PaulLSK/Iridium_9603_Beacon/Iridium_9603_Beacon_V5_BOM_Digikey.xls

Part | Quantity | X | Y | Angle | Package | Value | Manufacturer | Manufacturer Part No | Farnell Part No | Digikey P/N | McMaster Part No | Description | Alternative Part
C1,C7,C14,C15 | 4 | 30.48 | 23.91 | 180 | 0603 | 1uF | Walsin | 0603X105K100CT | 2496916 | 1276-1946-1-ND |  | MultiLayer Ceramic Capacitor; 1uF; 10V; 0603; X5R | 1uF 50V ±10% 0603 Samsung
C2,C4 | 2 | 40.96 | 26.45 | 0 | 0603 | 12pF | Walsin | 0603N120J500CT | 2496884 | 709-1141-1-ND |  | MultiLayer Ceramic Capacitor; 12pF; 50V; 0603 | 12pF 50V ±5% 0603 Samsung
C3,C5,C6,C8,C10,C19 | 6 | 16.26 | 35.21 | 270 | 0805 | 10uF | Walsin | 0805F106Z100CT | 2496998 | 1276-2717-1-ND |  | MultiLayer Ceramic Capacitor; 10uF; 10V; 0805 | 10uF 16V ±10% 0805 Samsung
C9,C13 | 2 | 15.24 | 38.13 | 0 | 0805 | 0.1uF | Walsin | 0805B104K500CT | 2496944 | 478-3755-1-ND |  | MultiLayer Ceramic Capacitor; 0.1uF; 50V; 0805; X7R | 100nF 50V ±10% 0805 Samsung
C16 | 1 | 36.77 | 46.70 | 0 | 0603 | 0.22uF | Multicomp | MC0603F224Z160CT | 1759019 | 311-1426-1-ND |  | MultiLayer Ceramic Capacitor; 0.22uF; 16V; 0603 | 220nF 25V ±10% 0603 Samsung
C17 | 1 | 36.80 | 54.45 | 0 | 0805 | 2.2uF | Multicomp | MCTT21X225K100CT | 1759477 | 445-1420-6-ND |  | MultiLayer Ceramic Capacitor; 2.2uF; 10V; 0805; X5R | 2.2uF 25V ±10% 0805 Samsung
C18 | 1 | 2.95 | 59.94 | 180 | 0805 | 10nF | Walsin | 0805B103K500CT | 2496939 | 1276-1015-6-ND |  | MultiLayer Ceramic Capacitor; 10nF; 50V; 0805; X7R | 10nF 50V ±5% 0805 Samsung
CON1 | 1 | 32.83 | 2.99 | 0 |  | Micro_USB | Amphenol_FCI | 10103594 | 2293752 | 609-4050-1-ND |  | Amphenol FCI 10103594 Micro USB Type B | A01SB7X4X1B21-167 Micro USB 5S B
CON4 | 1 | 44.89 | 59.98 | 90 | uFL | uFL | Hirose | U.FL-R-SMT(01) | 3908021 | H9161-ND |  | HIROSE U.FL-R-SMT(01); U.FL Coaxial; Straight Jack; 50 ohm
D1,D2,D3,D4,D5,D6 | 6 | 20.99 | 50.58 | 180 | SOD-123 | MBR120 | ON SEMICONDUCTOR | MBR120VLSFT1G | 1431044 | MBR120VLSFT1GOSDKR-ND |  | Schottky Rectifier; 20V; 1A; SOD-123
J1 | 1 | 26.27 | 42.10 | 0 |  | SS4-10-3.50 | Samtec | SS4-10-3.50-L-D-K-TR | 2085336 | SAM13255CT-ND |  | Samtec SS4-10-3.50-L-D-K-TR
L1 | 1 | 11.78 | 59.98 | 0 | 0805 | 33nH | Coilcraft | 0805HT-33NTGLB | 2286465 | 732-1783-1-ND |  | Surface Mount High Frequency Inductor; 0805; 33 nH; 600 mA | LQW2BHN33NJ03L Murata
LED1 | 1 | 25.05 | 8.83 | 0 |  | WS2812B | Sparkfun / Worldsemi | WS2812B |  | 1568-1800-ND |  | RGB LED with Driver
LED2 | 1 | 29.59 | 9.02 | 180 | 2.0x1.25 | RED | Wurth Electronik | 150080RS75000 | 2322077 | 732-4984-6-ND |  | LED; Red; 20mA; 2V; 2.0x1.25mm | Replaces Multicomp 703-0107
Q1,Q2,Q3,Q4 | 4 | 15.56 | 41.05 | 90 | SOT23 | DMG3415U-7 | Diodes Inc. | DMG3415U-7 | 1843688 | DMP2045U-7DIDKR-ND |  | MOSFET; P Channel; SOT23-WIDE
Q5 | 1 | 33.05 | 19.15 | 180 | SOT23 | 2N2222 | Fairchild | MMBT2222A | 9846700 | MMBT2222ATPMSDKR-ND |  | Bipolar (BJT) Single Transistor, NPN, 40 V, 350 mW, 1 A
R1,R3,R4,R6,R12,R13 | 6 | 19.37 | 40.93 | 270 | 0805 | 100k | Multicomp | MC01W08051100K | 9332405 | RMCF0805FG100KCT-ND |  | Chip Resistor; Thick Film; 100k; 150V; 0805; 100mW | 100K ±1% 0805 RoyalOhm
R2 | 1 | 48.32 | 46.86 | 0 | 0805 | 12K | Panasonic | ERJ6ENF1202V | 2303661 | RMCF0805FT12K0DKR-ND |  | Chip Resistor; Thick Film; 12k; 150V; 0805; 125mW | 12K ±1% 0805 RoyalOhm
R5,R8,R10,R14 | 4 | 16.95 | 29.85 | 0 | 0603 | 1K | Multicomp | MCWR06X1001FTL | 2447272 | 1276-3484-6-ND |  | Chip Resistor; Thick Film; 1k; 50V; 0603; 100mW | 1K ±1% 0603 RoyalOhm
R7 | 1 | 35.37 | 13.72 | 0 | 0603 | 47k | Multicomp | MCWR06X4702FTL | 2447376 | 1276-4808-6-ND |  | Chip Resistor; Thick Film; 47k; 50V; 0603; 100mW | 47K ±1% 0603 RoyalOhm
R9 | 1 | 8.00 | 59.98 | 180 | 0805 | 10 ohm | Multicomp | MC01W0805110R | 9332421 | A106055DKR-ND |  | Chip Resistor; Thick Film; 10 ohm; 150V; 0805; 100mW | 10R ±1% 0805 RoyalOhm
R11 | 1 | 53.40 | 46.86 | 180 | 0805 | 30K | Panasonic | ERJ6GEYJ303V | 2323830 | A126360DKR-ND |  | Chip Resistor; Thick Film; 30k; 150V; 0805; 125 mW | 30K ±1% 0805 RoyalOhm
R15,R16,R17 | 3 | 32.83 | 39.18 | 180 | 0603 | 10K | Multicomp | MCWR06X1002FTL | 2447230 | RNCP0603FTD10K0CT-ND |  | Chip Resistor; Thick Film; 10k; 50V; 0603; 100mW | 10K ±1% 0603 RoyalOhm
SW1 | 1 | 24.13 | 3.18 | 180 | 4.6x2.8 | Tactile Switch | Multicomp | MCIPTG23K-V | 1605470 | CKN10246CT-ND |  | Tactile Switch; 4.6x2.8mm; 50mA; 12V
U1 | 1 | 29.69 | 20.22 | 0 | SOT23-3 | MCP111T-240E/TT | Microchip | MCP111T-240E/TT | 1627192 | MCP111T-240E/TTDKR-ND |  | Reset Supervisor; SOT23-3; 2.40V; Open Drain; Active Low
U2 | 1 | 17.78 | 24.16 | 270 | SOT23-5 | SPX3819-3.3 | Exar | SPX3819M5-L-3-3/TR |  | 1016-1873-6-ND |  | LDO Voltage Regulator; 500mA; SOT-23-5
U3 | 1 | 39.05 | 43.02 | 90 | DFN-10 | LTC3225EDDB | Linear Technology | LTC3225EDDB#TRMPBF | 1715231 | LTC3225EDDB-1#TRMPBFCT-ND |  | Supercapacitor Charger
U4 | 1 | 12.03 | 33.69 | 180 | LGA8 | MPL3115A2 | NXP | MPL3115A2 | 2009084 | MPL3115A2-ND |  | Pressure Sensor
U5 | 1 | 30.48 | 30.26 | 90 | TQFN48 | ATSAMD21G18A | Atmel | ATSAMD21G18A-MF | 2460544 | ATSAMD21G18A-MFTDKR-ND |  | ATSAMD21G18A-MF; QFN48
U6 | 1 | 9.41 | 52.63 | 270 |  | MAX-M8Q | u-blox | MAX-M8Q |  | 672-1003-6-ND |  | https://www.u-blox.com/en/product/max-m8-series
U7 | 1 | 35.46 | 9.75 | 0 | MSOP8 | LT1634BCMS8-1.25 | Linear Technology | LT1634BCMS8-1.25 | 2252797 | LT1634BCMS8-1.25#PBF-ND |  | 1.25V Precision Voltage Reference
X1 | 1 | 37.66 | 27.72 | 270 | 3.2x1.5 | 32.768 | Epson | Q13FC13500004 | 1278036 | SER4103DKR-ND |  | Crystal; 32.768kHz; 12.5pF; 3.2 x 1.5mm
BAT1, BAT2, BAT3 | 6 |  |  |  |  | AA-Clip_Pair | Keystone Electronics | 92 | 908733 | 36-92-ND |  | Keystone Electronics 92 AA Battery Clip (Pair)
C11,C12 | 2 |  |  |  |  | 1F 2.7V | Bussmann | HV0810-2R7105-R | 2148482 | 283-4198-ND |  | Supercapacitor; 1F; 2.7V; +30%, -10%; 3.5mm Pitch
CON2,CON3 | 2 |  |  |  |  | SMA Jack | Johnson | 142-0711-821 | 1019328 | J629-ND |  | SMA End Launch Jack
RELAY1 | 1 |  |  |  |  | DPDT Latching | Omron | G6SK-2 3VDC |  | Z5234-ND |  | DPDT Latching Relay (Dual Coil) 3VDC
CABLE | 1 |  |  |  |  |  | HIROSE (HRS) | U.FL-2LP-088K1T-A-50 | 1688071 | H125218-ND |  | HIROSE u.FL - u.FL cable 50ohm 50mm
