PaulLSK/Iridium_9603_Beacon/Eagle/Iridium Board V5M - BOM for AAPCB - Revision 2.xlsx

Mfg Part # | Description | Value | Pkg | Description Value Pkg *AAPCB Format* | Ref. Des. | Qty | DNI | Notes | Mfg (Optional) | Vendor (Optional) | Vendor Part # (Optional) | Alternate Mfg Part # (Optional) | Type (Optional)
CL10B105KP8NNNC | CAP CER | 1uF 10V 10% | 0603 SMD | CAP CER 1uF 10V 10% 0603 SMD | C1,C7,C14,C15 | 4 |  |  | Samsung | Digi-key | 1276-1946-1-ND
500R14N120JV4T | CAP CER | 12 pF 50V 5% | 0603 SMD | CAP CER 12 pF 50V 5% 0603 SMD | C2,C4 | 2 |  |  | Johanson | Digi-key | 709-1141-1-ND
CL21X106KPCLRNC | CAP CER | 10uF 10V 10% | 0805 SMD | CAP CER 10uF 10V 10% 0805 SMD | C3,C5,C6,C8,C10,C19 | 6 |  |  | Samsung | Digi-key | 1276-2717-1-ND
08053C104KAT2A | CAP CER | 0.1UF 25V 10% | 0805 SMD | CAP CER 0.1UF 25V 10% 0805 SMD | C9,C13 | 2 |  |  | AVX | Digi-key | 478-3755-1-ND
CC0603KRX7R7BB224 | CAP CER | 0.22uF 16V 10% | 0603 SMD | CAP CER 0.22uF 16V 10% 0603 SMD | C16 | 1 |  | Alternate Part: 220nF 25V ±10% 0603 Samsung | Yageo | Digi-key | 311-1426-1-ND
CL21B225KAFNFNE | CAP CER | 2.2uF 25V 10% | 0805 SMD | CAP CER 2.2uF 25V 10% 0805 SMD | C17 | 1 |  |  | Samsung | Digi-key | 1276-2953-1-ND
CL21B103KBANNNC | CAP CER | 10nF 50V 10% | 0805 SMD | CAP CER 10nF 50V 10% 0805 SMD | C18 | 1 |  |  | Samsung | Digi-key | 1276-1015-6-ND
10103594-0001LF | CONN RCPT | USB2.0 | MICRO B SMD | CONN RCPT USB2.0 MICRO B SMD | CON1 | 1 |  |  | Amphenol | Digi-key | 609-4050-1-ND
U.FL-R-SMT(01) | CONN U.FL RCPT | STR 50 OHM | SMD | CONN U.FL RCPT STR 50 OHM SMD | CON4 | 1 |  |  | Hirose | Digi-key | H9161-ND
MBR120VLSFT1G | DIODE SCHOTTKY | 20V 1A | SOD-123 SMD | DIODE SCHOTTKY 20V 1A SOD-123 SMD | D1,D2,D3,D4,D5 | 5 |  |  | ON Semi | Digi-key | MBR120VLSFT1GOSDKR-ND
SS4-10-3.50-L-D-K-TR | .4MM SOCKET STRIP | 20 POS | SMD | .4MM SOCKET STRIP 20 POS SMD | J1 | 1 |  |  | Samtec | Digi-key | SAM13255CT-ND
74476013C | FIXED IND | 33nH 500mA 270 MOHM | 0805 SMD | FIXED IND 33nH 500mA 270 MOHM 0805 SMD | L1 | 1 |  |  | Wurth Elec | Digi-key | 732-1783-1-ND
COM-13667 | LED | RGB | SMD | LED RGB SMD | LED1 | 1 |  | Must be this part number. | Sparkfun | Sparkfun | SMD LED - RGB WS2812B
150080RS75000 | LED | RED CLEAR | 0805 SMD | LED RED CLEAR 0805 SMD | LED2 | 1 |  |  | Wurth Elec | Digi-key | 732-4984-6-ND
DMP2045U-7 | MOSFET P-CHAN | 24V | SOT-23 SMD | MOSFET P-CHAN 24V SOT-23 SMD | Q1,Q2,Q3,Q4 | 4 |  |  | Diodes Inc | Digi-key | DMP2045U-7DIDKR-ND
MMBT2222A-TP | TRANS NPN | 40V 0.6A | SOT-23 SMD | TRANS NPN 40V 0.6A SOT-23 SMD | Q5 | 1 |  |  | Micro Commercial | Digi-key | MMBT2222ATPMSDKR-ND
RMCF0805FG100K | RES | 100K 1% 1/8W | 0805 SMD | RES 100K 1% 1/8W 0805 SMD | R1,R3,R4,R6,R12,R13 | 6 |  |  | Stackpole Elec | Digi-key | RMCF0805FG100KCT-ND
RMCF0805FT12K0 | RES | 12K 1% 1/8W | 0805 SMD | RES 12K 1% 1/8W 0805 SMD | R2 | 1 |  |  | Stackpole Elec | Digi-key | RMCF0805FT12K0DKR-ND
RC1608F102CS | RES | 1K 1% 1/10W | 0603 SMD | RES 1K 1% 1/10W 0603 SMD | R5,R8,R10,R14 | 3 |  |  | Samsung | Digi-key | 1276-3484-6-ND
RC1608F473CS | RES | 47K 1% 1/10W | 0603 SMD | RES 47K 1% 1/10W 0603 SMD | R7 | 1 |  |  | Samsung | Digi-key | 1276-4808-6-ND
CRG0805F10R | RES | 10 1% 1/8W | 0805 SMD | RES 10 1% 1/8W 0805 SMD | R9 | 1 |  |  | TE Connectivity | Digi-key | A106055DKR-ND
CRG0805F30K | RES | 30K 1% 1/8W | 0805 SMD | RES 30K 1% 1/8W 0805 SMD | R11 | 1 |  |  | TE Connectivity | Digi-key | A126360DKR-ND
RNCP0603FTD10K0 | RES | 10K 1% 1/8W | 0603 SMD | RES 10K 1% 1/8W 0603 SMD | R15,R16,R17 | 3 |  |  | Stackpole Elec | Digi-key | RNCP0603FTD10K0CT-ND
KMR231NG LFS | SWITCH TACTILE SPST-NO | 0.05A 32V | SMD | SWITCH TACTILE SPST-NO 0.05A 32V SMD | SW1 | 1 |  |  | C&K | Digi-key | CKN10246CT-ND
MCP111T-240E/TT | IC VOLT DET | 2.32V LOW | SOT-23-3 SMD | IC VOLT DET 2.32V LOW SOT-23-3 SMD | U1 | 1 |  |  | Microchip | Digi-key | MCP111T-240E/TTDKR-ND
SPX3819M5-L-3-3/TR | IC REG LINEAR | 3.3V 500mA | SOT-23-5 SMD | IC REG LINEAR 3.3V 500mA SOT-23-5 SMD | U2 | 1 |  |  | MaxLinear | Digi-key | 1016-1873-6-ND
LTC3225EDDB-1#TRMPBF | IC SUPERCAP CHARGER | 150mA | 10-DFN SMD | IC SUPERCAP CHARGER 150mA 10-DFN SMD | U3 | 1 |  |  | Linear | Digi-key | LTC3225EDDB-1#TRMPBFCT-ND
MPL3115A2 | IC ALTIMETER I2C |  | 8-LGA SMD | IC ALTIMETER I2C 8-LGA SMD | U4 | 1 |  |  | NXP USA | Digi-key | MPL3115A2-ND
ATSAMD21G18A-MFT | IC MCU 32BIT 256KB FLASH |  | 48-QFN | IC MCU 32BIT 256KB FLASH 48-QFN | U5 | 1 |  |  | Microchip | Digi-key | ATSAMD21G18A-MFTDKR-ND
MAX-M8Q-0 | IC RECEIVER GPS/GNSS |  | 18LCC SMD | IC RECEIVER GPS/GNSS 18LCC SMD | U6 | 1 |  |  | U-Blox America | Digi-key | 672-1003-6-ND
LT1634BCMS8-1.25#PBF | IC VREF SHUNT | 1.25V | 8-MSOP SMD | IC VREF SHUNT 1.25V 8-MSOP SMD | U7 | 1 |  |  | Linear | Digi-key | LT1634BCMS8-1.25#PBF-ND
FC-135 32.7680KA-A5 | CRYSTAL | 32.7680 kHz 12.5 pF | SMD | CRYSTAL 32.7680 kHz 12.5 pF SMD | X1 | 1 |  |  | EPSON | Digi-key | SER4103DKR-ND
92 | BATT CONTACT CLIP |  | PC PIN | BATT CONTACT CLIP PC PIN | BAT1,BAT2,BAT3,BAT4,BAT5,BAT6 | 12 | DNI |  | Keystone Elec | Digi-key | 36-92-ND
HV0810-2R7105-R | CAP | 1F -10% +30% 2.7V | RADIAL | CAP 1F -10% +30% 2.7V RADIAL | C11,C12 | 2 | DNI |  | Eaton | Digi-key | 283-4198-ND
G6SK-2 DC3 | RELAY TELECOM DPDT | 2A 250V | PC PIN | RELAY TELECOM DPDT 2A 250V PC PIN | RELAY1 | 1 | DNI |  | Omron | Digi-key | Z5234-ND
142-0701-871 | CONN SMA JACK STR | 50 OHM | BOARD EDGE | CONN SMA JACK STR 50 OHM BOARD EDGE | GNSS,IRIDIUM | 2 | DNI | Bulkhead Version, Enclosure Cutout: 7 mm diameter (1/4", 6.35 datasheet) | Cinch Connectivity | Digi-key | J610-ND
7101K2AV2QE | SWITCH TOGGLE SPDT | 5A 120V | PC PIN | SWITCH TOGGLE SPDT 5A 120V PC PIN | U53 | 1 | DNI | Enclosure Cutout: 7 mm diameter (1/4", 6.35 datasheet) | C&K | Digi-key | CKN1441-ND
1053091204 | CONN HEADER VERT MALE | 4POS 2.5MM | PIN | CONN HEADER VERT MALE 4POS 2.5MM PIN |  | 2 | DNI |  | Molex | Digi-key | WM14967-ND
1053071204 | NANOFIT RCPT |  |  | NANOFIT RCPT |  | 2 | DNI |  | Molex | Digi-key | WM14960-ND
1053002200 | NANOFIT CRIMP TERM |  |  | NANOFIT CRIMP TERM |  | 10 | DNI |  | Molex | Digi-key | WM14957CT-ND
LF10WBR-4S | CONN RCPT FMALE | 4POS |  | CONN RCPT FMALE 4POS |  | 2 | DNI | Enclosure cutout: 11.05 mm diameter datasheet (11 actual) | Hirose | Digi-key | HR557-ND
U.FL-2LP-088K1T-A-(50) | CBL ASSY U.FL PLUG-PLUG | 1.969" |  | CBL ASSY U.FL PLUG-PLUG 1.969" |  | 1 | DNI |  | Hirose | Digi-key | H125218-ND
LCS_032_CTP | LIGHTPIPE THREADED |  |  | LIGHTPIPE THREADED |  | 1 | DNI | Enclosure cutout: 7.93 mm diameter datasheet (8 mm actual) | VCC | Digi-key | LCS_032_CTP-ND
95117A411 | PRESS-FIT NUT | 2-56 0.07" HEIGHT |  | PRESS-FIT NUT 2-56 0.07" HEIGHT | S1,S2 | 2 | DNI |  |  | McMaster-Carr | 95117A411
94669A100 | ALUMINUM SPACER | M2.5 Screw Size, 4.5 mm OD, 6 mm Long |  | ALUMINUM SPACER M2.5 Screw Size, 4.5 mm OD, 6 mm Long |  | 2 | DNI |  |  | McMaster-Carr | 94669A100
92185A081 | 316 STAINLESS SOCKET HEAD SCREW | 2-56 7/16" Long |  | 316 STAINLESS SOCKET HEAD SCREW 2-56 7/16" Long |  | 2 | DNI |  |  | McMaster-Carr | 92185A081
90107A003 | 316 STAINLESS WASHER | #2 Screw, 0.094" ID, 0.25" OD |  | 316 STAINLESS WASHER #2 Screw, 0.094" ID, 0.25" OD |  | 2 | DNI |  |  | McMaster-Carr | 90107A003
92147A410 | 316 STAINLESS SPLIT WASHER | #2 Screw, 0.094" ID, 0.172" OD |  | 316 STAINLESS SPLIT WASHER #2 Screw, 0.094" ID, 0.172" OD |  | 2 | DNI |  |  | McMaster-Carr | 92147A410
92290A113 | 316 STAINLESS SOCKET HEAD SCREW | M3 x 0.5 Thread, 8 mm Long |  | 316 STAINLESS SOCKET HEAD SCREW M3 x 0.5 Thread, 8 mm Long |  | 7 | DNI |  |  | McMaster-Carr | 92290A113
90965A130 | 316 STAINLESS WASHER | M3 Screw, 3.2 mm ID, 7 mm OD |  | 316 STAINLESS WASHER M3 Screw, 3.2 mm ID, 7 mm OD |  | 7 | DNI |  |  | McMaster-Carr | 90965A130
92153A416 | 316 STAINLESS SPLIT WASHER | M3 Screw, 3.4 mm ID, 6.2 mm OD |  | 316 STAINLESS SPLIT WASHER M3 Screw, 3.4 mm ID, 6.2 mm OD |  | 7 | DNI |  |  | McMaster-Carr | 92153A416
94500A226 | 316 STAINLESS BUTTON HEAD HEX SCREW | M4 x 0.7 mm, 8 mm Long |  | 316 STAINLESS BUTTON HEAD HEX SCREW M4 x 0.7 mm, 8 mm Long |  | 6 | DNI |  |  | McMaster-Carr | 94500A226
90965A150 | 316 STAINLESS WASHER | M4 Screw, 4.3 mm ID, 0.9 mm OD |  | 316 STAINLESS WASHER M4 Screw, 4.3 mm ID, 0.9 mm OD |  | 6 | DNI |  |  | McMaster-Carr | 90965A150
92153A418 | 316 STAINLESS SPLIT WASHER | M4 Screw, 4.4 mm ID, 7.6 mm OD |  | 316 STAINLESS SPLIT WASHER M4 Screw, 4.4 mm ID, 7.6 mm OD |  | 6 | DNI |  |  | McMaster-Carr | 92153A418
