PaulLSK/Iridium_9603_Beacon/Eagle/BOM TEMPLATE for AAPCB.xlsx

Best Practice Bill of Materials (BOM) Template
1. Reference Designators - Place all designators with the same part number in one cell
2. Description Value Package - Advanced Assembly's system perfers this to be combined into one cell
3. Alternate Part Numbers - Place in additional columns to the right on the same line
4. Do Not Install (DNI) Parts - Indicate quantity zero and/or add DNI column
5. Notes - Place in additional column on the same line
6. Refrain from using merged cells
*Please contact your account executive with any questions.*
 |  |  |  | êAuto-populates as you fill in the previous cellsê
Mfg Part # | Description | Value | Pkg | Description Value Pkg *AAPCB Format* | Ref. Des. | Qty | DNI | Notes | Mfg (Optional) | Vendor (Optional) | Vendor Part # (Optional) | Alternate Mfg Part # (Optional) | Type (Optional)
12065A330JAT2A | CAP | .33pF@5V | 1206 | CAP .33pF@5V 1206 | U1, U2 | 2 |  |  | AVX Corp
C1206C104K3HACTU | CAP CER | 0.1UF 25V 10% | 1206 | CAP CER 0.1UF 25V 10% 1206 | C10, C19, C26, C27, C28, C36, C57, C59, C102, C103, C104, C108, C109 | 13 |  | Must purchase from Digi-Key | Kemet | Digi-Key | 399-5714-1-ND
VFT2045BP-M3/4W | Diode Schottkey | 45V 20A | ITO-220AC | Diode Schottkey 45V 20A ITO-220AC | D1 | 1 |  |  | Vishay
CDH53-680JC | Inductor Power | 68uH 1.5Arms 0.18 DCR | TSSOP | Inductor Power 68uH 1.5Arms 0.18 DCR TSSOP | L1 | 0 | DNI |  | Sumida
ERJ-1TNF1201U | Resistor | 12K OHM 1W 1% | 2512 SMD | Resistor 12K OHM 1W 1% 2512 SMD | R5, R6 | 2 |  |  | Panasonic
SRR6603-4R7ML | Inductor Power | 4.7uH | SMD | Inductor Power 4.7uH SMD | L2, L3 | 2 |  |  | Bourns
ERJ-6GEYK226V | RES | 22M OHM 1/8W 10% | 0805 SMD | RES 22M OHM 1/8W 10% 0805 SMD | R138 | 0 | DNI |  | Panasonic | Digi-Key | P22MACT-ND
CL10B105KP8NNNC | CAP CER | 1uF 10V 10% | 0603 SMD | CAP CER 1uF 10V 10% 0603 SMD | C1, C7, C14, C15 | 4 |  |  | Samsung | Digi-key | 1276-1946-1-ND
 | CAP CER |  |  | CAP CER | C2, C4
CL21X106KPCLRNC | CAP CER | 10uF 10V 10% | 0805 SMD | CAP CER 10uF 10V 10% 0805 SMD | C3, C5, C6, C8, C10, C19 | 6 |  |  | Samsung | Digi-key | 1276-2717-1-ND
08053C104KAT2A | CAP CER | 0.1UF 25V 10% | 0805 SMD | CAP CER 0.1UF 25V 10% 0805 SMD | C9, C13 | 2 |  |  | AVX | Digi-key | 478-3755-1-ND
CC0603KRX7R7BB224 | CAP CER | 0.22uF 16V 10% | 0603 SMD | CAP CER 0.22uF 16V 10% 0603 SMD | C16 | 1 |  | Alternate Part: 220nF 25V ±10% 0603 Samsung | Yageo | Digi-key | 311-1426-1-ND
C2012X7R1C225K125AB | CAP CER | 2.2uF 16V 10% | 0805 SMD | CAP CER 2.2uF 16V 10% 0805 SMD |  |  |  | Alternate Part: 2.2uF 25V ±10% 0805 Samsung | TDK | Digi-key | 445-1420-6-ND
