PaulLSK/Iridium_9603_Beacon/Eagle/Iridium_9603_Beacon_V5M_Eagle_BOM.csv

Part | Value | Device | Package | Description | DESCRIPTION | HEIGHT | MANUFACTURER_NAME | MANUFACTURER_PART_NUMBER | MF | MPN | OC_FARNELL | OC_NEWARK | PACKAGE | PROD_ID | RS_PART_NUMBER | RS_PRICE/STOCK | SUPPLIER
3V3 |  | PINHD-1X1 | 1X01 | Pin header 1x1 for 0.1 spacing"
3V3SW |  | PINHD-1X1 | 1X01 | Pin header 1x1 for 0.1 spacing"
BAT- |  | PINHD-1X1 | 1X01 | Pin header 1x1 for 0.1 spacing"
BAT1 |  | BATTERYKEYSTONE92 | BATTERY-AAA-KEYSTONE92 | Battery Holders
BAT2 |  | BATTERYKEYSTONE92 | BATTERY-AAA-KEYSTONE92 | Battery Holders
BAT3 |  | BATTERYKEYSTONE92 | BATTERY-AAA-KEYSTONE92 | Battery Holders
BAT4 |  | BATTERYKEYSTONE92 | BATTERY-AAA-KEYSTONE92 | Battery Holders
BAT5 |  | BATTERYKEYSTONE92 | BATTERY-AAA-KEYSTONE92 | Battery Holders
BAT6 |  | BATTERYKEYSTONE92 | BATTERY-AAA-KEYSTONE92 | Battery Holders
C1 | 1uF | CAP_CERAMIC0603_NO | 0603-NO | Ceramic Capacitors
C2 | 22pF | CAP_CERAMIC0603_NO | 0603-NO | Ceramic Capacitors
C3 | 10uF | CAP_CERAMIC0805-NOOUTLINE | 0805-NO | Ceramic Capacitors
C4 | 22pF | CAP_CERAMIC0603_NO | 0603-NO | Ceramic Capacitors
C5 | 10uF | CAP_CERAMIC0805-NOOUTLINE | 0805-NO | Ceramic Capacitors
C6 | 10µF | CAP_CERAMIC0805-NOOUTLINE | 0805-NO | Ceramic Capacitors
C7 | 1uF | CAP_CERAMIC0603_NO | 0603-NO | Ceramic Capacitors
C8 | 10µF | CAP_CERAMIC0805-NOOUTLINE | 0805-NO | Ceramic Capacitors
C9 | 0.1uF | CAP_CERAMIC0805-NOOUTLINE | 0805-NO | Ceramic Capacitors
C10 | 10uF | CAP_CERAMIC0805-NOOUTLINE | 0805-NO | Ceramic Capacitors
C11 | 1F 2.7V | 1F-2.7V(PTH)CPOL-RADIAL-1H-2.7V | CPOL-RADIAL-1F-2.7V | CAP-08070
C12 | 1F 2.7V | 1F-2.7V(PTH)CPOL-RADIAL-1H-2.7V | CPOL-RADIAL-1F-2.7V | CAP-08070
C13 | 0.1uF | CAP_CERAMIC0805-NOOUTLINE | 0805-NO | Ceramic Capacitors
C14 | 1uF | CAP_CERAMIC0603_NO | 0603-NO | Ceramic Capacitors
C15 | 1uF | CAP_CERAMIC0603_NO | 0603-NO | Ceramic Capacitors
C16 | 0.22uF | CAP_CERAMIC0603_NO | 0603-NO | Ceramic Capacitors
C17 | 2.2uF | CAP_CERAMIC0805-NOOUTLINE | 0805-NO | Ceramic Capacitors
C18 | 10nF | CAP_CERAMIC0805-NOOUTLINE | 0805-NO | Ceramic Capacitors
C19 | 10uF | CAP_CERAMIC0805-NOOUTLINE | 0805-NO | Ceramic Capacitors
COM1 |  | PINHD-1X1 | 1X01 | Pin header 1x1 for 0.1 spacing"
COM2 |  | PINHD-1X1 | 1X01 | Pin header 1x1 for 0.1 spacing"
CON1 |  | USBFCI_10103594 | FCI_10103594 | USB Connectors
CON4 | uFL | ANTENNA_U.FL | U.FL | U.FL Antenna Connector
CS |  | PINHD-1X1 | 1X01 | Pin header 1x1 for 0.1 spacing"
D1 | MBR120 | DIODE-SCHOTTKYSOD-123 | SOD-123
D2 | MBR120 | DIODE-SCHOTTKYSOD-123 | SOD-123
D3 | MBR120 | DIODE-SCHOTTKYSOD-123 | SOD-123
D4 | MBR120 | DIODE-SCHOTTKYSOD-123 | SOD-123
FD1 | FIDUCIAL1X2 | FIDUCIAL1X2 | FIDUCIAL-1X2 | Fiducial Alignment Points
FD2 | FIDUCIAL1X2 | FIDUCIAL1X2 | FIDUCIAL-1X2 | Fiducial Alignment Points
FD3 | FIDUCIAL1X2 | FIDUCIAL1X2 | FIDUCIAL-1X2 | Fiducial Alignment Points
GND |  | PINHD-1X1 | 1X01 | Pin header 1x1 for 0.1 spacing"
GND2 |  | PINHD-1X1 | 1X01 | Pin header 1x1 for 0.1 spacing"
GND3 |  | PINHD-1X1 | 1X01 | Pin header 1x1 for 0.1 spacing"
GND4 |  | PINHD-1X1 | 1X01 | Pin header 1x1 for 0.1 spacing"
GND5 |  | PINHD-1X1 | 1X01 | Pin header 1x1 for 0.1 spacing"
GND6 |  | PINHD-1X1 | 1X01 | Pin header 1x1 for 0.1 spacing"
GNSS | SMA-142-0711-821/826 | SMA-142-0711-821/826 | J502-ND-142-0711-821/826 | SMA 50 Ohm End Launch Jack Receptacle - Round Contact |  |  |  |  | JOHNSON COMPONENTS | 142-0711-821 | 1019328 | 16F3627
IRIDIUM | SMA-142-0711-821/826 | SMA-142-0711-821/826 | J502-ND-142-0711-821/826 | SMA 50 Ohm End Launch Jack Receptacle - Round Contact |  |  |  |  | JOHNSON COMPONENTS | 142-0711-821 | 1019328 | 16F3627
J1 | SS4-10-3.50-X-D | SS4-10-3.50-X-D | SS4-10-3.50-X-D | 0.4mm[.016] SOCKET STRIP ASSEMBLY.
JP1 |  | JUMPER-PAD-3-2OF3_NC_BY_TRACE_LARGE | PAD-JUMPER-3-2OF3_NC_BY_TRACE_YES_SILK_LARGE
JP2 |  | JUMPER-PAD-3-2OF3_NC_BY_TRACE_LARGE | PAD-JUMPER-3-2OF3_NC_BY_TRACE_YES_SILK_LARGE
L1 | 33nH | FERRITE-0805NO | 0805-NO | Ferrite Bead
LED1 |  | WS2812B | WS2812B | WS2812B - Intelligent control LED integrated light source |  |  |  |  |  |  |  |  |  | DIO-12503
LED2 | RED | LED0805_NOOUTLINE | CHIPLED_0805_NOOUTLINE | LED
MISO |  | PINHD-1X1 | 1X01 | Pin header 1x1 for 0.1 spacing"
MOSI |  | PINHD-1X1 | 1X01 | Pin header 1x1 for 0.1 spacing"
NC1 |  | PINHD-1X1 | 1X01 | Pin header 1x1 for 0.1 spacing"
NC2 |  | PINHD-1X1 | 1X01 | Pin header 1x1 for 0.1 spacing"
NO1 |  | PINHD-1X1 | 1X01 | Pin header 1x1 for 0.1 spacing"
NO2 |  | PINHD-1X1 | 1X01 | Pin header 1x1 for 0.1 spacing"
Q1 | DMG3415U-7 | MOSFET-PWIDE | SOT23-WIDE | P-Channel Mosfet
Q2 | DMG3415U-7 | MOSFET-PWIDE | SOT23-WIDE | P-Channel Mosfet
Q3 | DMG3415U-7 | MOSFET-PWIDE | SOT23-WIDE | P-Channel Mosfet
Q4 | DMG3415U-7 | MOSFET-PWIDE | SOT23-WIDE | P-Channel Mosfet
Q5 | 2N2222 | MMBT2222ALT1-NPN-SOT23-BEC | SOT23-BEC | NPN Transistror
R1 | 100K | RESISTOR0805_NOOUTLINE | 0805-NO | Resistors
R2 | 12K | RESISTOR0805_NOOUTLINE | 0805-NO | Resistors
R3 | 100K | RESISTOR0805_NOOUTLINE | 0805-NO | Resistors
R4 | 100K | RESISTOR0805_NOOUTLINE | 0805-NO | Resistors
R5 | 1K | RESISTOR_0603_NOOUT | 0603-NO | Resistors
R6 | 100K | RESISTOR0805_NOOUTLINE | 0805-NO | Resistors
R7 | 47k | RESISTOR_0603_NOOUT | 0603-NO | Resistors
R8 | 1K | RESISTOR_0603_NOOUT | 0603-NO | Resistors
R9 | 10 ohm | RESISTOR0805_NOOUTLINE | 0805-NO | Resistors
R10 | 2.2K | RESISTOR_0603_NOOUT | 0603-NO | Resistors
R11 | 30K | RESISTOR0805_NOOUTLINE | 0805-NO | Resistors
R12 | 100K | RESISTOR0805_NOOUTLINE | 0805-NO | Resistors
R13 | 100K | RESISTOR0805_NOOUTLINE | 0805-NO | Resistors
R14 | 1K | RESISTOR_0603_NOOUT | 0603-NO | Resistors
R15 | 10K | RESISTOR_0603_NOOUT | 0603-NO | Resistors
R16 | 10K | RESISTOR_0603_NOOUT | 0603-NO | Resistors
R17 | 10K | RESISTOR_0603_NOOUT | 0603-NO | Resistors
RELAY1 | G6SK-2_DC5 | G6SK-2_DC5 | G6SK2DC5 | RELAY TELECOM DPDT 2A 5V | RELAY TELECOM DPDT 2A 5V | 9mm | Omron Electronics | G6SK-2 DC5
RST |  | PINHD-1X1 | 1X01 | Pin header 1x1 for 0.1 spacing"
S1 | STANDOFF_ELECTRICALMCMASTER-95117A411 | STANDOFF_ELECTRICALMCMASTER-95117A411 | STANDOFF-ELECTRICAL-MCMASTER-95117A411 | A standoff intended to be an electrically connected point.
S2 | STANDOFF_ELECTRICALMCMASTER-95117A411 | STANDOFF_ELECTRICALMCMASTER-95117A411 | STANDOFF-ELECTRICAL-MCMASTER-95117A411 | A standoff intended to be an electrically connected point.
SCK |  | PINHD-1X1 | 1X01 | Pin header 1x1 for 0.1 spacing"
SCL |  | PINHD-1X1 | 1X01 | Pin header 1x1 for 0.1 spacing"
SDA |  | PINHD-1X1 | 1X01 | Pin header 1x1 for 0.1 spacing"
SERCOM2_RX |  | PINHD-1X1 | 1X01 | Pin header 1x1 for 0.1 spacing"
SERCOM2_TX |  | PINHD-1X1 | 1X01 | Pin header 1x1 for 0.1 spacing"
SW1 |  | SWITCH_SPST_4_PINRECT | TACTILE_SWITCH_SMD_4.6X2.8MM |  |  |  |  |  |  |  |  |  |  | SWCH-13065
SWCLK |  | PINHD-1X1 | 1X01 | Pin header 1x1 for 0.1 spacing"
SWDIO |  | PINHD-1X1 | 1X01 | Pin header 1x1 for 0.1 spacing"
U$53 | 7101K2AV2QE | 7101K2AV2QE | AV2_SPDT | Digikey Par#: CKN1441-ND
U1 | MCP111T-240E/TT | MCP111T-270E/TT | SOT95P237X112-3N | Micropower Voltage Detector ,SOT23-3; |  |  |  |  |  | MCP111T-240E/TT | 1851877 | 56J7328 | SOT23-3 |  |  |  | MICROCHIP
U2 | SPX3819-3.3 | VREG_SOT23-5 | SOT23-5 | SOT23-5 Fixed Voltage Regulators
U3 | LTC3225EDDB#TRMPBF | LTC3225EDDB-TRMPBFDFN300X200-10L | DFN300X200-10L | 150mA Supercapacitor Charger
U4 | MPL3115A2LGA8 | MPL3115A2LGA8 | LGA8 | Altimeter/Pressure Sensor, I2C, 1.95V-3.6V supply, 50 to 110kPa |  |  |  |  |  |  |  |  |  | IC-10869
U5 | ATSAMD21G18_QFN | ATSAMD21J_QFN | TQFN48_7MM
U6 | MAX-M8 | MAX-M8 | MAX-M8 | u-blox MAX GNSS module
U7 | LT1634-1,25BMCMS8 | LT1634-1,25BMCMS8 | MSOP8 | Micropower Precision Shunt Voltage Reference
VBUS |  | PINHD-1X1 | 1X01 | Pin header 1x1 for 0.1 spacing"
X1 | 32.768 | XTAL-3.2X1.5 | XTAL3215 | Low cost SMT crystals, no capacitors included
