PaulLSK/Iridium_9603_Beacon/CAD/BELFUSE_1420701871/142-0701-871.stp

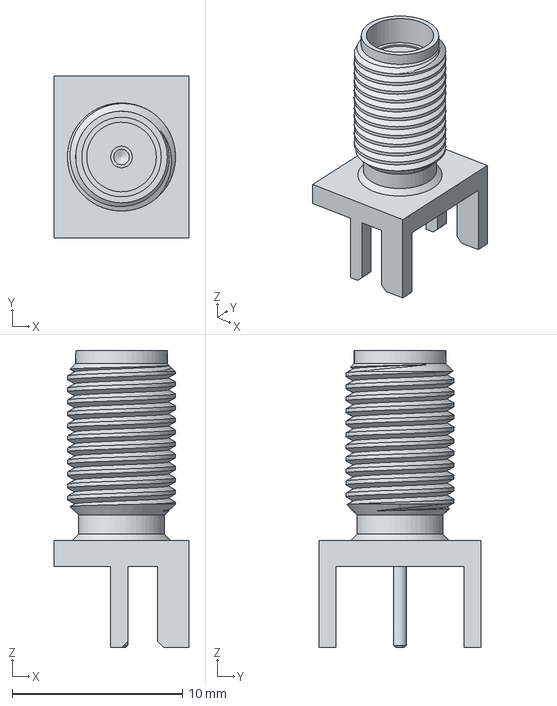
[picture p1: CAD file, 2019-01-15]
CAD/BELFUSE_1420701871/142-0701-871.stp
7.92 x 9.53 x 17.4 mm
