PaulLSK/Iridium_9603_Beacon/CAD/BELFUSE_1420711821/142-0711-821.stp

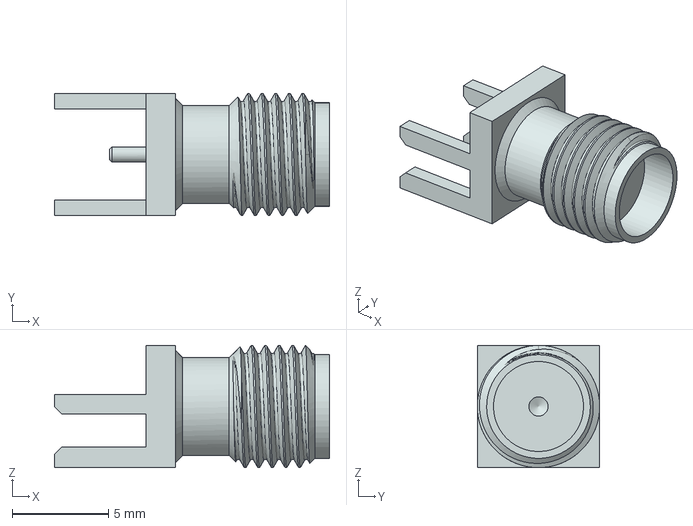
[picture p2: CAD file, 2019-01-02]
CAD/BELFUSE_1420711821/142-0711-821.stp
14.3 x 6.35 x 6.35 mm
