PaulLSK/Iridium_9603_Beacon/CAD/ENG_CVM_5-102618-1_K.3d_stp/c-0102618-51-k-3d.stp

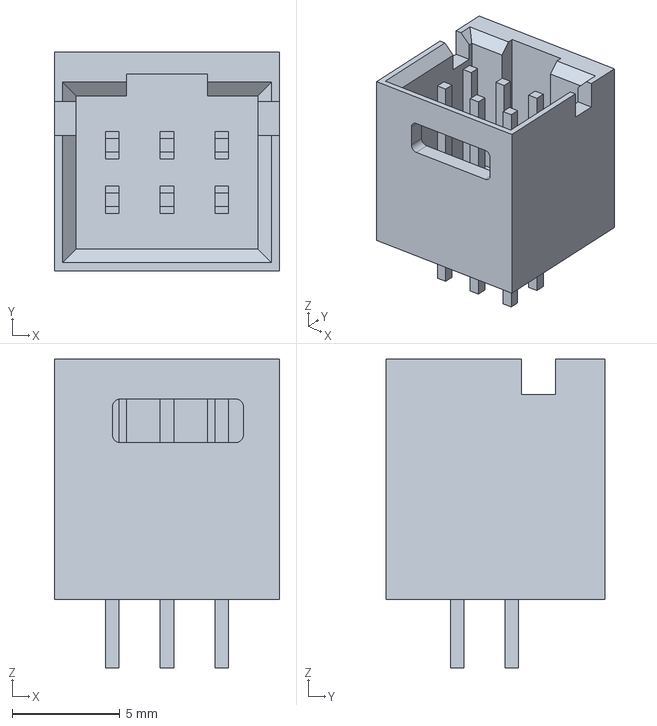
[picture p3: CAD file, 2019-01-02]
CAD/ENG_CVM_5-102618-1_K.3d_stp/c-0102618-51-k-3d.stp
10.5 x 10.2 x 14.4 mm
