PaulLSK/Iridium_9603_Beacon/CAD/G6SK_2_STEP/G6SK_2.step

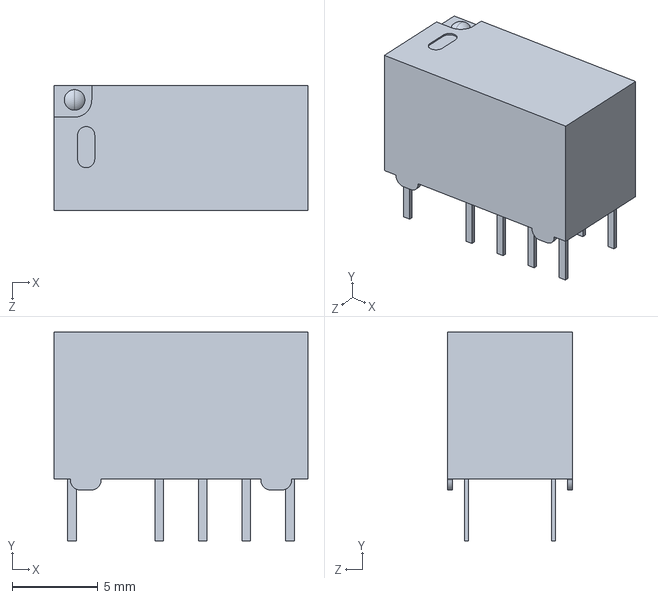
[picture p4: CAD file, 2019-01-23]
CAD/G6SK_2_STEP/G6SK_2.step
14.8 x 12.2 x 7.30 mm
