PaulLSK/Iridium_9603_Beacon/CAD/Iridium_9603_Beacon_V5M(7).step

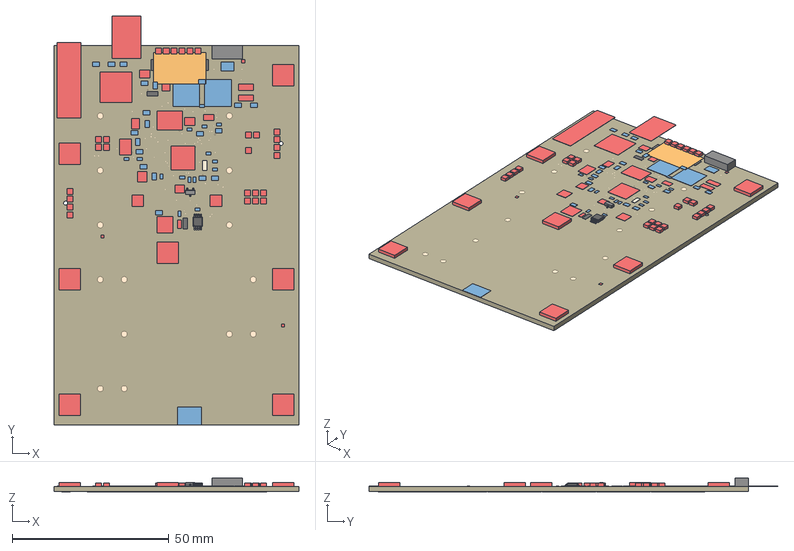
[picture p5: CAD file, 2019-01-23]
CAD/Iridium_9603_Beacon_V5M(7).step
78.0 x 130.4 x 4.34 mm
Board
100K x 20
10K x 15
SPX3819-3.3
MBR120 x 4
ATSAMD21G18_QFN
DMG3415U-7 x 4
MPL3115A2LGA8
SS4-10-3.50-X-D
1X01 x 27
STANDOFF_ELECTRICALMCMASTER-95117A411 x 2
1F 2.7V x 2
LTC3225EDDB#TRMPBF
TACTILE_SWITCH_SMD_4.6X2.8MM
FCI_10103594
FIDUCIAL1X2 x 3
PAD-JUMPER-3-2OF3_NC_BY_TRACE_YES_SILK_LARGE x 2
MCP111T-240E/TT
BATTERY-AAA-KEYSTONE92 x 6
uFL
MAX-M8
SMA-142-0711-821/826
WS2812B
SMA-142-0711-821/826_1
LT1634-1,25BMCMS8
RED
G6SK-2_DC5
2N2222
3,2 x 7
7101K2AV2QE
