PaulLSK/Iridium_9603_Beacon/CAD/LF_01363001800_3dstep/LF10WBR-C.stp

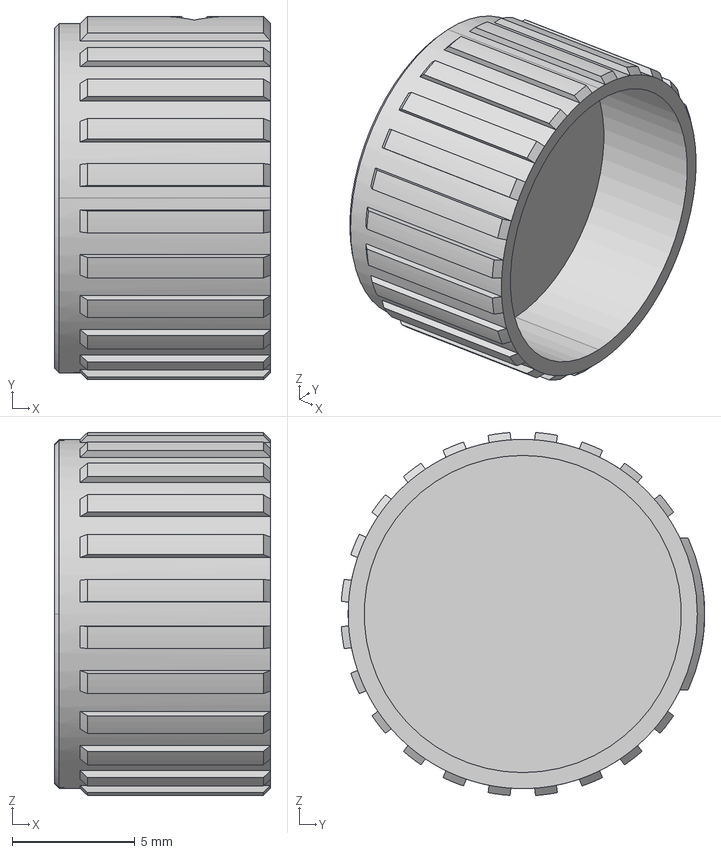
[picture p6: CAD file, 2019-01-23]
CAD/LF_01363001800_3dstep/LF10WBR-C.stp
8.80 x 14.8 x 14.8 mm
