PaulLSK/Iridium_9603_Beacon/CAD/LCS 032 RTP.IGS

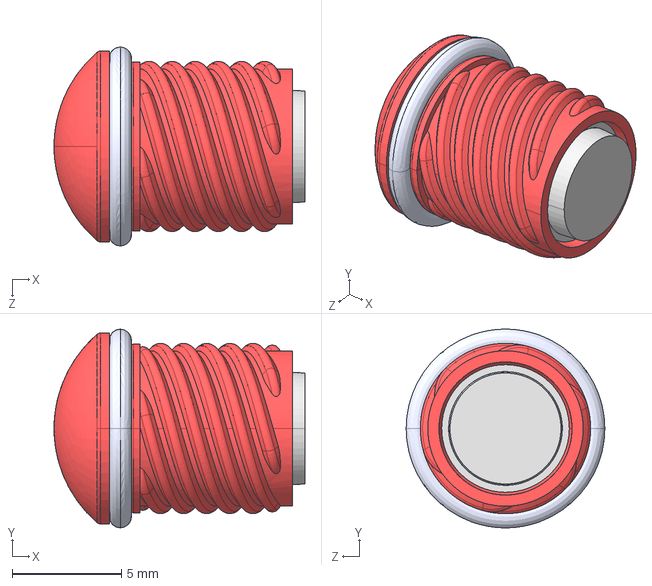
[picture p7: CAD file, 2019-01-23]
CAD/LCS 032 RTP.IGS
11.5 x 9.10 x 9.10 mm
