PaulLSK/Iridium_9603_Beacon/CAD/keystone-PN92.STEP

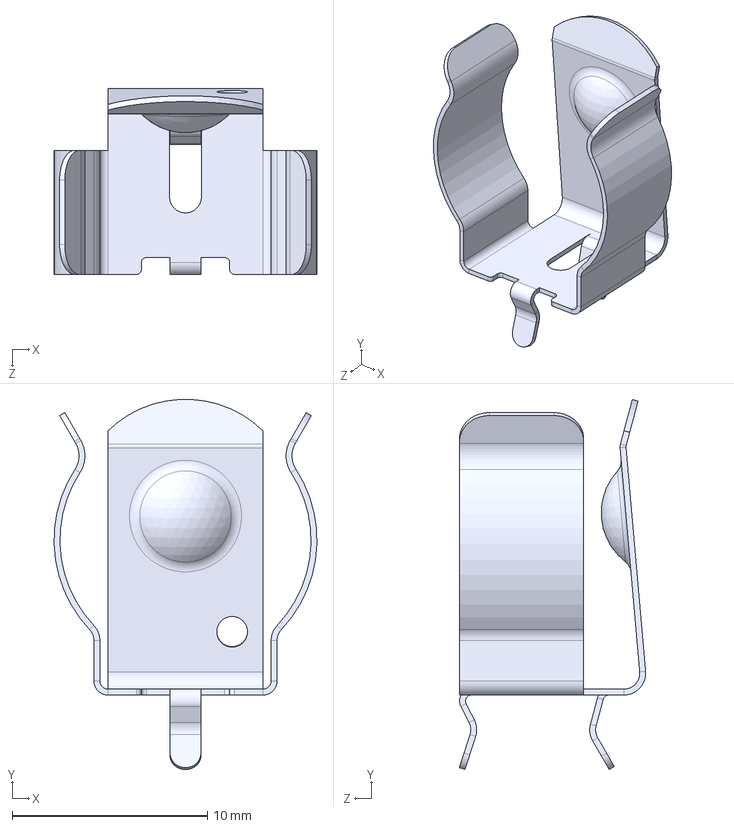
[picture p8: CAD file, 2019-01-02]
CAD/keystone-PN92.STEP
13.5 x 18.9 x 9.54 mm
