PaulLSK/Iridium_9603_Beacon/CAD/BSO-M3-20ZI-PennEngineering-12-31-2018.stp

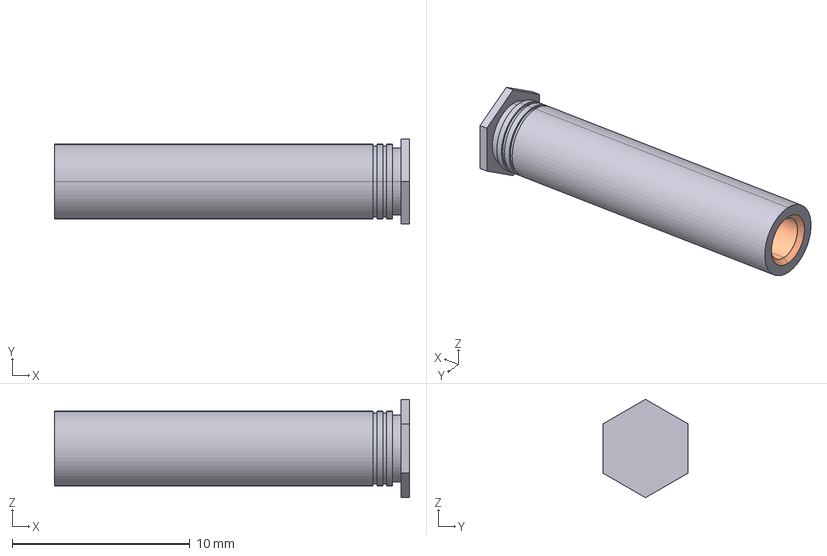
[picture p9: CAD file, 2019-01-02]
CAD/BSO-M3-20ZI-PennEngineering-12-31-2018.stp
20.0 x 4.80 x 5.54 mm
