PaulLSK/Iridium_9603_Beacon/CAD/93090A635_PRESS-FIT FEMALE ROUND STANDOFFS.STEP

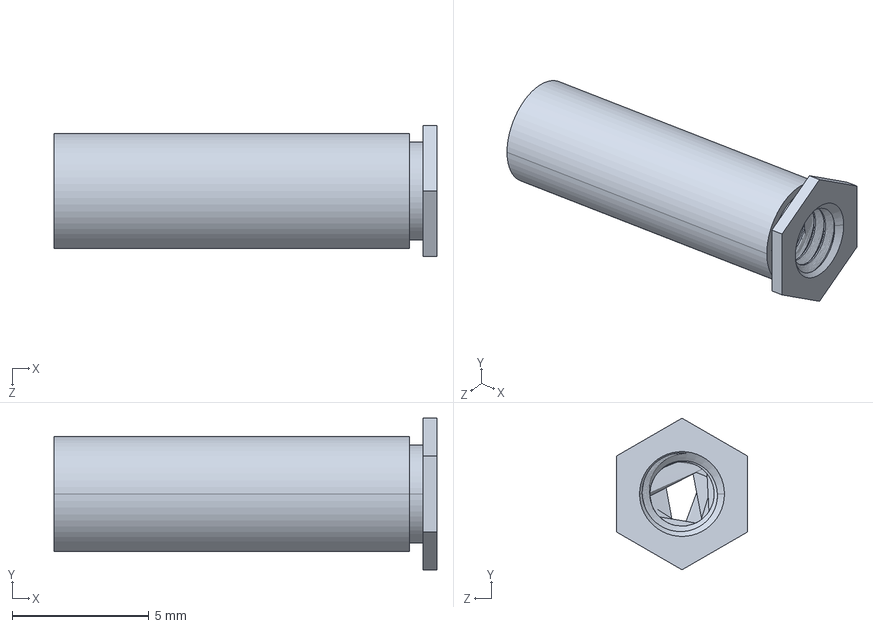
[picture p10: CAD file, 2019-01-02]
CAD/93090A635_PRESS-FIT FEMALE ROUND STANDOFFS.STEP
14.0 x 5.54 x 4.80 mm
