PaulLSK/Iridium_9603_Beacon/(list of files, cad)

Other CAD files:
CAD/Iridium_9603_Beacon_V5M(5) - OSH Park R0 Order.step
CAD/AA_Battery.b877e503-0576-4231-a7e3-62d7da980c33.f3d
