PaulLSK/Iridium_9603_Beacon/Beacon Board Test Report.xlsx

Board Number | Enclosure Fit Check | Feather M0 Bootloader Installed | V5M Test Program (NO antennas and NO modem) | Reset Button | V5M Test Program (with modem and antennas) | V5M Test Program - GPS Lock | V5 XDATA Program - XDATA Serial Data | V5 XDATA Program - iMET Serial Data | V5 XDATA Program - GPS Lock | V5 XDATA Program - Iridium Message (No ISBDCallBack) | V5 XDATA Program - Iridium Message (ISBDCallBack) | Battery Test - 3 AA in Group 1 | Battery Test - 3 AA in Group 2 | Battery Test - 6 AA | 3.3 Volts | V5 XDATA Program - XDATA Serial Data through Panel Mount Connector [no modem] | V5 XDATA Program - iMET Serial Data through Panel Mount Connector [no modem] | Modem Connector Epoxied | Enclosure Connectors Epoxied | Board Conformal Coating | V5 XDATA Program - Iridium Message - Battery Operated | V5 Test Program - GPS Lock [after confromal coating]
1 | PASS | Yes | PASS | PASS | PASS | PASS | PASS | PASS | PASS |  | PASS (Messages 365 to 368) | PASS | PASS | PASS | PASS | PASS | PASS | Yes | Yes | Yes | PASS (Messages 408-417) | PASS
2 | PASS | Yes | PASS | PASS | PASS | PASS | PASS | PASS | PASS | PASS (Messages 353-356) | PASS (Message 358) | PASS | PASS | PASS | PASS | PASS | PASS | Yes | Yes | Yes | PASS (Messages 405-407) | PASS
3 | PASS | Yes | PASS (2nd test), Relay NC (clicked on NC test 1st test) | PASS | PASS | PASS | PASS | PASS | PASS |  | PASS (Message 362) | PASS | PASS | PASS | PASS | PASS | PASS | Yes | Yes | Yes | PASS (Messages 398) | PASS
4 | PASS | Yes | PASS (2nd test), PGOOD Not Go High (1st test) | PASS | PASS | PASS | PASS | PASS | PASS |  | PASS (Messages 370 to 377) | PASS | PASS | PASS | PASS | PASS | PASS | Yes | Yes | Yes | PASS (Messages 418-424) | PASS
5 | PASS | Yes | PASS (2nd test), Relay NC (clicked on NC test 1st test) | PASS | PASS | PASS | PASS | PASS | PASS |  | PASS (Messages 378 to 385) | PASS | PASS | PASS | PASS | PASS | PASS | Yes | Yes | Yes | PASS (Messages 425-432) | PASS
6 | PASS | Yes | PASS (2nd test), PGOOD Not Go High (1st test) | PASS | PASS | PASS | PASS | PASS | PASS |  | PASS (Message 361) | PASS | PASS | PASS | PASS | PASS | PASS | Yes | Yes | Yes | PASS (Messages 396-397) | PASS
7 | PASS | Yes | PASS | PASS | PASS | PASS | PASS | PASS | PASS |  | PASS (Messages 359, 360) | PASS | PASS | PASS | PASS | PASS | PASS | Yes | Yes | Yes | PASS (Messages 401-404) | PASS
8 | PASS | Yes | PASS | PASS | PASS | PASS | PASS | PASS | PASS |  | PASS (Message 364) | PASS | PASS | PASS | PASS | PASS | PASS | Yes | Yes | Yes | PASS (Messages 399-400) | PASS
9 | PASS | Yes | PASS | PASS | PASS | PASS | PASS | PASS | PASS |  | PASS (Messages 386 to 391) | PASS | PASS | PASS | PASS | PASS | PASS | Yes | Yes | Yes | PASS (Messages 392-394)
