PaulLSK/Iridium_9603_Beacon/Eagle/Iridium_9603_Beacon_V5M.brd

## EAGLE design Eagle/Iridium_9603_Beacon_V5M.brd (2019-02-04)

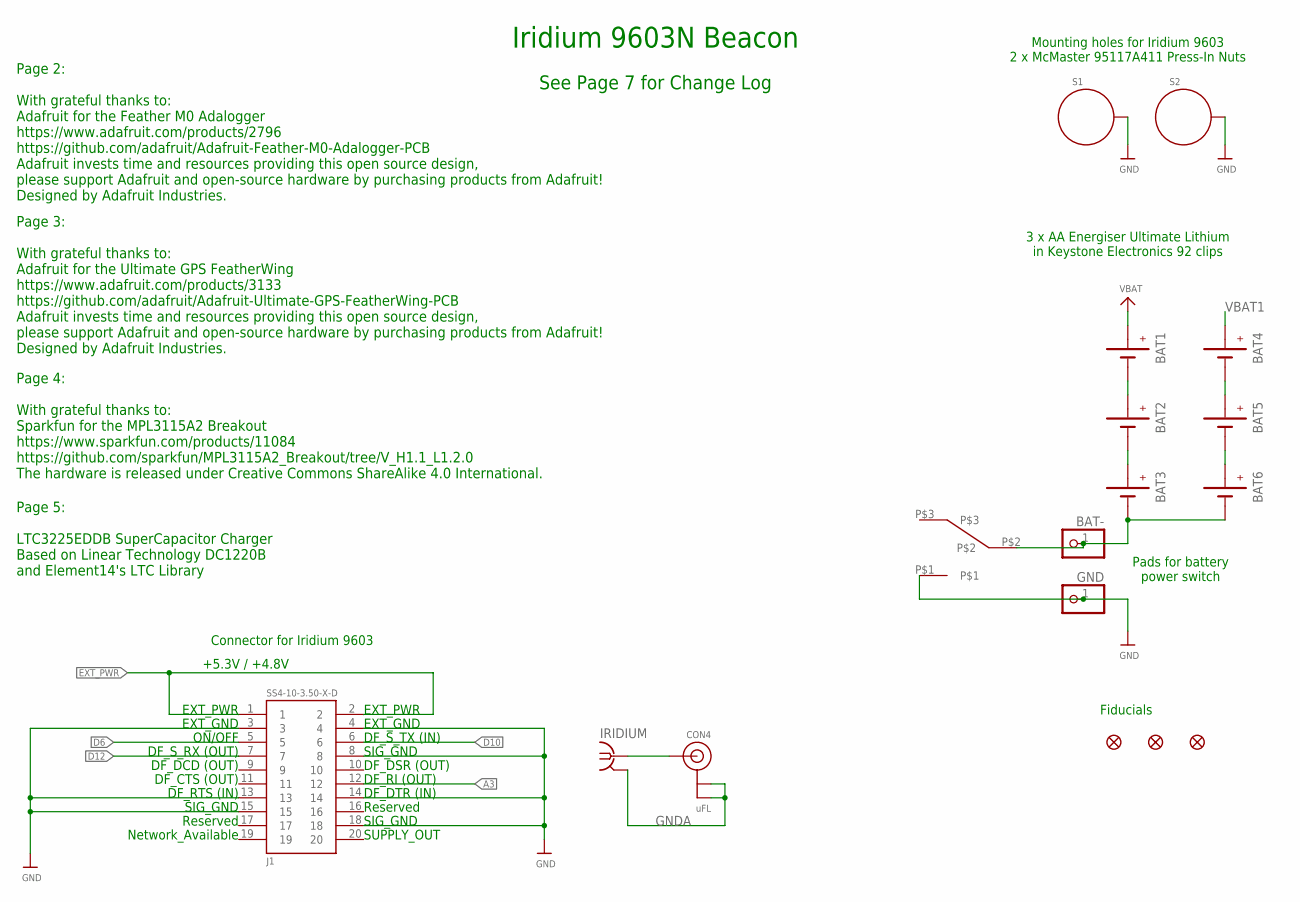
[picture p11: schematic Iridium_9603_Beacon_V5M.sch, sheet 1]

Parts:
BAT1, BAT2, BAT3, BAT4, BAT5, BAT6: BATTERYKEYSTONE92; BATTERY-AAA-KEYSTONE92
BAT-: PINHD-1X1; 1X01
CON4: uFL; U.FL
FD1, FD2, FD3: FIDUCIAL1X2; FIDUCIAL-1X2
GND: PINHD-1X1; 1X01
IRIDIUM: SMA-142-0711-821/826; J502-ND-142-0711-821/826
J1: SS4-10-3.50-X-D
S1, S2: STANDOFF_ELECTRICALMCMASTER-95117A411; STANDOFF-ELECTRICAL-MCMASTER-95117A411
U53: 7101K2AV2QE; AV2_SPDT

Connections:
A3: J1.12; also elsewhere on the board
D6: J1.5; also elsewhere on the board
D10: J1.6; also elsewhere on the board
D12: J1.7; also elsewhere on the board
EXT_PWR: J1.1, J1.2; also elsewhere on the board
GND: GND.1, J1.3, J1.4, J1.8, J1.13, J1.14, J1.15, J1.18, S1.P1, S2.P1, U53.P$1; also elsewhere on the board
GNDA: CON4.1 (GND), CON4.2 (GND), IRIDIUM.G@1 (2), IRIDIUM.G@2 (2), IRIDIUM.G@3 (2), IRIDIUM.G@4 (2)
unnamed: CON4.3 (SIGNAL), IRIDIUM.1
unnamed: BAT1.GND@1 (-), BAT1.GND@2 (-), BAT2.PWR@1 (+), BAT2.PWR@2 (+)
unnamed: BAT3.GND@1 (-), BAT3.GND@2 (-), BAT6.GND@1 (-), BAT6.GND@2 (-), BAT-.1, U53.P$2
unnamed: BAT2.GND@1 (-), BAT2.GND@2 (-), BAT3.PWR@1 (+), BAT3.PWR@2 (+)
unnamed: BAT4.GND@1 (-), BAT4.GND@2 (-), BAT5.PWR@1 (+), BAT5.PWR@2 (+)
unnamed: BAT5.GND@1 (-), BAT5.GND@2 (-), BAT6.PWR@1 (+), BAT6.PWR@2 (+)
VBAT: BAT1.PWR@1 (+), BAT1.PWR@2 (+); also elsewhere on the board
VBAT1: BAT4.PWR@1 (+), BAT4.PWR@2 (+); also elsewhere on the board

Notes on the sheet:
3 x AA Energiser Ultimate Lithium in Keystone Electronics 92 clips
Connector for Iridium 9603
Mounting holes for Iridium 9603 2 x McMaster 95117A411 Press-In Nuts
Iridium 9603N Beacon
Page 2: With grateful thanks to: Adafruit for the Feather M0 Adalogger https://www.adafruit.com/products/2796 https://github.com/adafruit/Adafruit-Feather-M0-Adalogger-PCB Adafruit invests time and resources providing this open source design, please support Adafruit and open-source hardware by purc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
Page 3: With grateful thanks to: Adafruit for the Ultimate GPS FeatherWing https://www.adafruit.com/products/3133 https://github.com/adafruit/Adafruit-Ultimate-GPS-FeatherWing-PCB Adafruit invests time and resources providing this open source design, please support Adafruit and open-source hardware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
Page 4: With grateful thanks to: Sparkfun for the MPL3115A2 Breakout https://www.sparkfun.com/products/11084 https://github.com/sparkfun/MPL3115A2_Breakout/tree/V_H1.1_L1.2.0 The hardware is released under Creative Commons ShareAlike 4.0 International.
EXT_PWR
EXT_GND
ON/OFF
DF_S_RX (OUT)
DF_DCD (OUT)
DF_CTS (OUT)
DF_RTS (IN)
SIG_GND
Reserved
Network_Available
DF_S_TX (IN)
DF_DSR (OUT)
DF_RI (OUT)
DF_DTR (IN)
SUPPLY_OUT
Page 5: LTC3225EDDB SuperCapacitor Charger Based on Linear Technology DC1220B and Element14's LTC Library
+5.3V / +4.8V
Fiducials
See Page 7 for Change Log
Pads for battery power switch

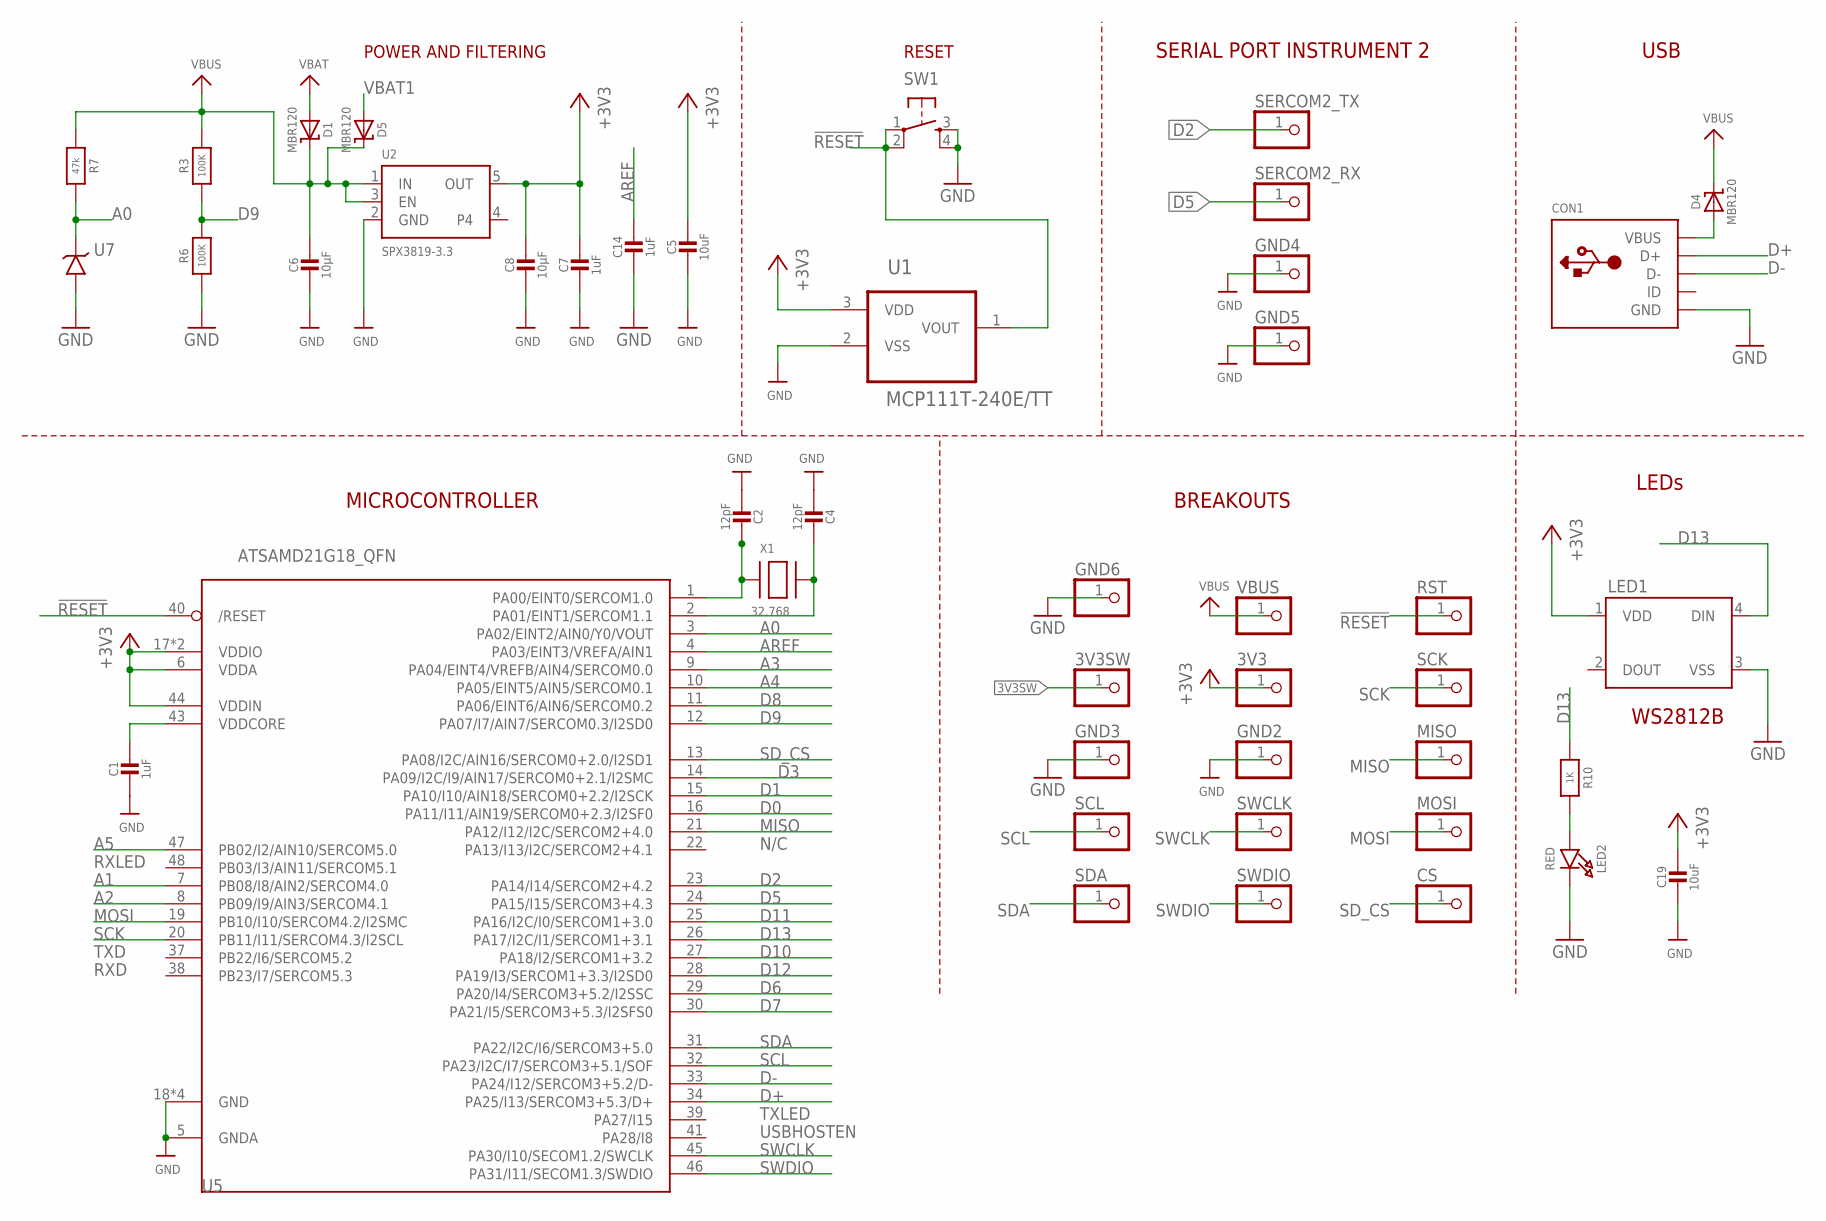
[picture p12: schematic Iridium_9603_Beacon_V5M.sch, sheet 2]

Parts:
3V3, 3V3SW: PINHD-1X1; 1X01
C1, C7, C14: 1uF; 0603-NO
C2, C4: 12pF; 0603-NO
C5, C19: 10uF; 0805-NO
C6, C8: 10µF; 0805-NO
CON1: USBFCI_10103594; FCI_10103594
CS: PINHD-1X1; 1X01
D1, D4, D5: MBR120; SOD-123
GND2, GND3, GND4, GND5, GND6: PINHD-1X1; 1X01
LED1: WS2812B
LED2: RED; CHIPLED_0805_NOOUTLINE
MISO: PINHD-1X1; 1X01
MOSI: PINHD-1X1; 1X01
R3, R6: 100K; 0805-NO
R7: 47k; 0603-NO
R10: 1K; 0603-NO
RST: PINHD-1X1; 1X01
SCK: PINHD-1X1; 1X01
SCL: PINHD-1X1; 1X01
SDA: PINHD-1X1; 1X01
SERCOM2_RX, SERCOM2_TX: PINHD-1X1; 1X01
SW1: SWITCH_SPST_4_PINRECT; TACTILE_SWITCH_SMD_4.6X2.8MM
SWCLK: PINHD-1X1; 1X01
SWDIO: PINHD-1X1; 1X01
U1: MCP111T-240E/TT; SOT95P237X112-3N; MPN MCP111T-240E/TT
U2: SPX3819-3.3; SOT23-5
U5: ATSAMD21G18_QFN; TQFN48_7MM
U7: LT1634-1,25BMCMS8; MSOP8
VBUS: PINHD-1X1; 1X01
X1: 32.768; XTAL3215

Connections:
3V3SW: 3V3SW.1; also elsewhere on the board
!RESET: RST.1, SW1.1, SW1.2, U1.1 (VOUT), U5.40 (/RESET)
+3V3: 3V3.1, C5.1, C7.1, C8.1, C19.1, LED1.1 (VDD), U1.3 (VDD), U2.5 (OUT), U5.6 (VDDA), U5.17 (VDDIO), U5.36 (VDDIO), U5.44 (VDDIN); also elsewhere on the board
A0: R7.2, U5.3 (PA02/EINT2/AIN0/Y0/VOUT), U7.6 (VOUT)
A1: U5.7 (PB08/I8/AIN2/SERCOM4.0); also elsewhere on the board
A2: U5.8 (PB09/I9/AIN3/SERCOM4.1)
A3: U5.9 (PA04/EINT4/VREFB/AIN4/SERCOM0.0); also elsewhere on the board
A4: U5.10 (PA05/EINT5/AIN5/SERCOM0.1)
A5: U5.47 (PB02/I2/AIN10/SERCOM5.0); also elsewhere on the board
AREF: C14.1, U5.4 (PA03/EINT3/VREFA/AIN1)
D0: U5.16 (PA11/I11/AIN19/SERCOM0+2.3/I2SF0); also elsewhere on the board
D1: U5.15 (PA10/I10/AIN18/SERCOM0+2.2/I2SCK); also elsewhere on the board
D2: SERCOM2_TX.1, U5.23 (PA14/I14/SERCOM2+4.2)
D3: U5.14 (PA09/I2C/I9/AIN17/SERCOM0+2.1/I2SMC); also elsewhere on the board
D5: SERCOM2_RX.1, U5.24 (PA15/I15/SERCOM3+4.3)
D6: U5.29 (PA20/I4/SERCOM3+5.2/I2SSC); also elsewhere on the board
D7: U5.30 (PA21/I5/SERCOM3+5.3/I2SFS0); also elsewhere on the board
D8: U5.11 (PA06/EINT6/AIN6/SERCOM0.2); also elsewhere on the board
D9: R3.1, R6.2, U5.12 (PA07/I7/AIN7/SERCOM0.3/I2SD0)
D10: U5.27 (PA18/I2/SERCOM1+3.2); also elsewhere on the board
D11: U5.25 (PA16/I2C/I0/SERCOM1+3.0); also elsewhere on the board
D12: U5.28 (PA19/I3/SERCOM1+3.3/I2SD0); also elsewhere on the board
D13: LED1.4 (DIN), R10.1, U5.26 (PA17/I2C/I1/SERCOM1+3.1)
D+: CON1.D+, U5.34 (PA25/I13/SERCOM3+5.3/D+)
D-: CON1.D-, U5.33 (PA24/I12/SERCOM3+5.2/D-)
GND: C1.2, C2.2, C4.2, C5.2, C6.2, C7.2, C8.2, C14.2, C19.2, CON1.BASE@1 (GND), CON1.BASE@2 (GND), CON1.GND, CON1.SPRT@1 (GND), CON1.SPRT@2 (GND), CON1.SPRT@3 (GND), CON1.SPRT@4 (GND), GND2.1, GND3.1, GND4.1, GND5.1, GND6.1, LED1.3 (VSS), LED2.C, R6.1, SW1.3, SW1.4, U1.2 (VSS), U2.2 (GND), U5.5 (GNDA), U5.18 (GND), U5.35 (GND), U5.42 (GND), U5.THERMAL (GND), U7.4 (GND); also elsewhere on the board
MISO: MISO.1, U5.21 (PA12/I12/I2C/SERCOM2+4.0)
MOSI: MOSI.1, U5.19 (PB10/I10/SERCOM4.2/I2SMC)
unnamed: LED2.A, R10.2
unnamed: C2.1, U5.1 (PA00/EINT0/SERCOM1.0), X1.P$1
unnamed: C4.1, U5.2 (PA01/EINT1/SERCOM1.1), X1.P$2
unnamed: CON1.VBUS, D4.A
SCK: SCK.1, U5.20 (PB11/I11/SERCOM4.3/I2SCL)
SCL: SCL.1, U5.32 (PA23/I2C/I7/SERCOM3+5.1/SOF); also elsewhere on the board
SDA: SDA.1, U5.31 (PA22/I2C/I6/SERCOM3+5.0); also elsewhere on the board
SD_CS: CS.1, U5.13 (PA08/I2C/AIN16/SERCOM0+2.0/I2SD1)
SWCLK: SWCLK.1, U5.45 (PA30/I10/SECOM1.2/SWCLK)
SWDIO: SWDIO.1, U5.46 (PA31/I11/SECOM1.3/SWDIO)
VBAT: D1.A; also elsewhere on the board
VBAT1: D5.A; also elsewhere on the board
VBUS: C6.1, D1.C, D4.C, D5.C, R3.2, R7.1, U2.1 (IN), U2.3 (EN), VBUS.1; also elsewhere on the board
VDDCORE1: C1.1, U5.43 (VDDCORE)

Notes on the sheet:
POWER AND FILTERING
RESET
N/C
TXLED
USBHOSTEN
RXLED
TXD
RXD
USB
BREAKOUTS
LEDs
MICROCONTROLLER
WS2812B
SERIAL PORT INSTRUMENT 2

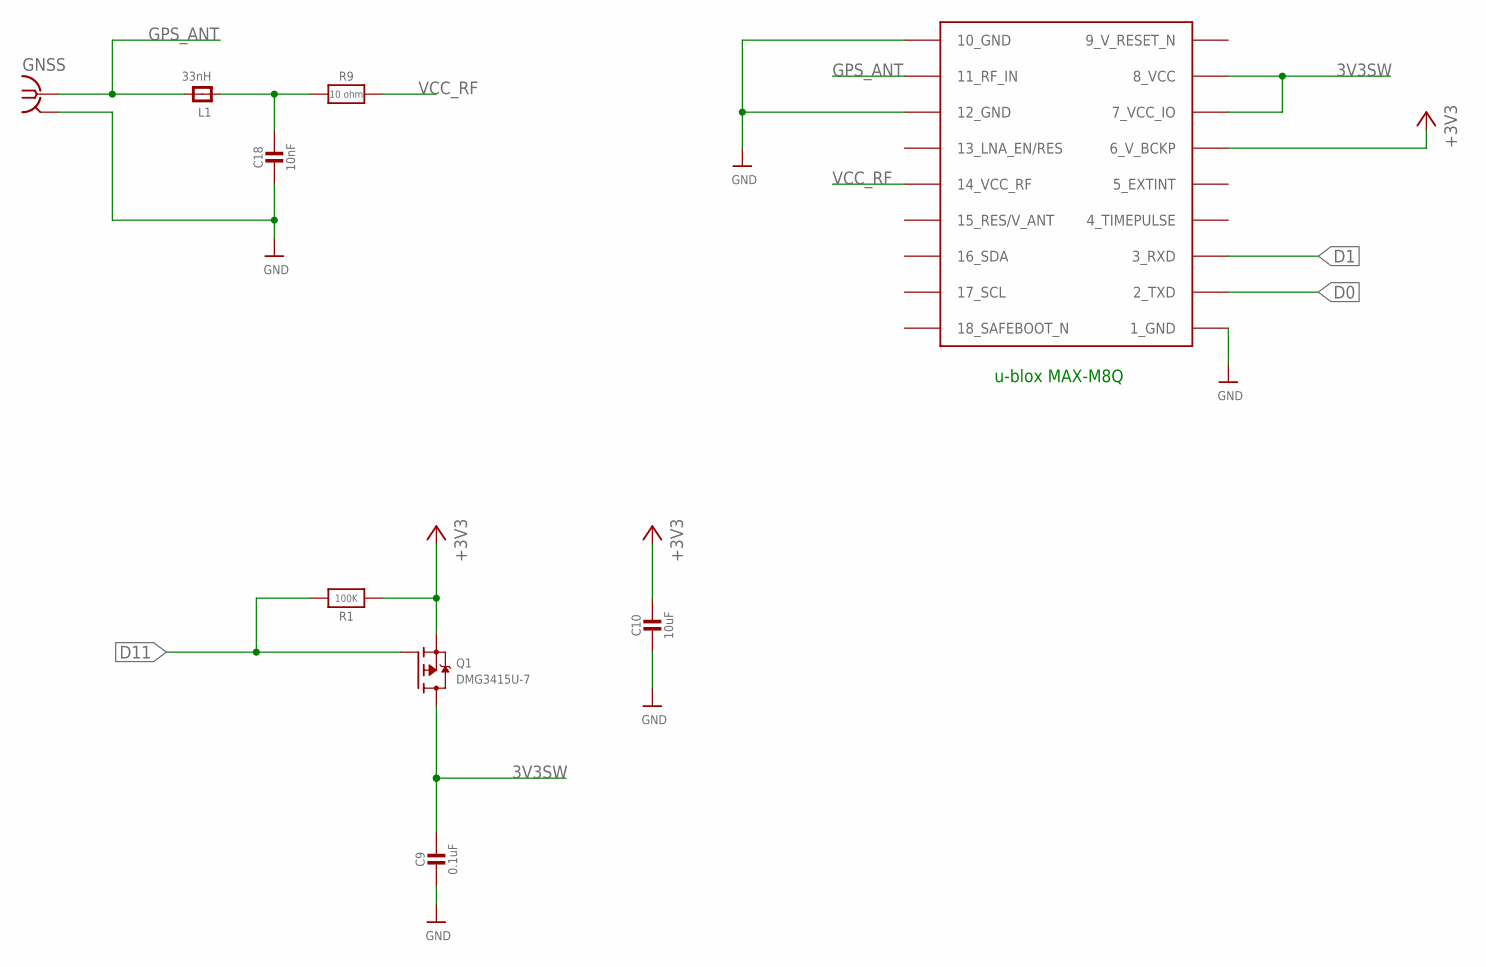
[picture p13: schematic Iridium_9603_Beacon_V5M.sch, sheet 3]

Parts:
C9: 0.1uF; 0805-NO
C10: 10uF; 0805-NO
C18: 10nF; 0805-NO
GNSS: SMA-142-0711-821/826; J502-ND-142-0711-821/826
L1: 33nH; 0805-NO
Q1: DMG3415U-7; SOT23-WIDE
R1: 100K; 0805-NO
R9: 10 ohm; 0805-NO
U6: MAX-M8

Connections:
3V3SW: C9.1, Q1.3 (D), U6.7_VCC_IO, U6.8_VCC; also elsewhere on the board
9_V_RESET_N: U6.9_RESET_N (9_V_RESET_N)
+3V3: C10.1, Q1.2 (S), R1.1, U6.6_V_BCKP; also elsewhere on the board
D0: U6.2_TXD; also elsewhere on the board
D1: U6.3_RXD; also elsewhere on the board
D11: Q1.1 (G), R1.2; also elsewhere on the board
GND: C9.2, C10.2, C18.2, GNSS.G@1 (2), GNSS.G@2 (2), GNSS.G@3 (2), GNSS.G@4 (2), U6.1_GND, U6.10_GND, U6.12_GND; also elsewhere on the board
GPS_ANT: GNSS.1, L1.2, U6.11_RF_IN
unnamed: C18.1, L1.1, R9.1
VCC_RF: R9.2, U6.14_VCC_RF

Notes on the sheet:
u-blox MAX-M8Q

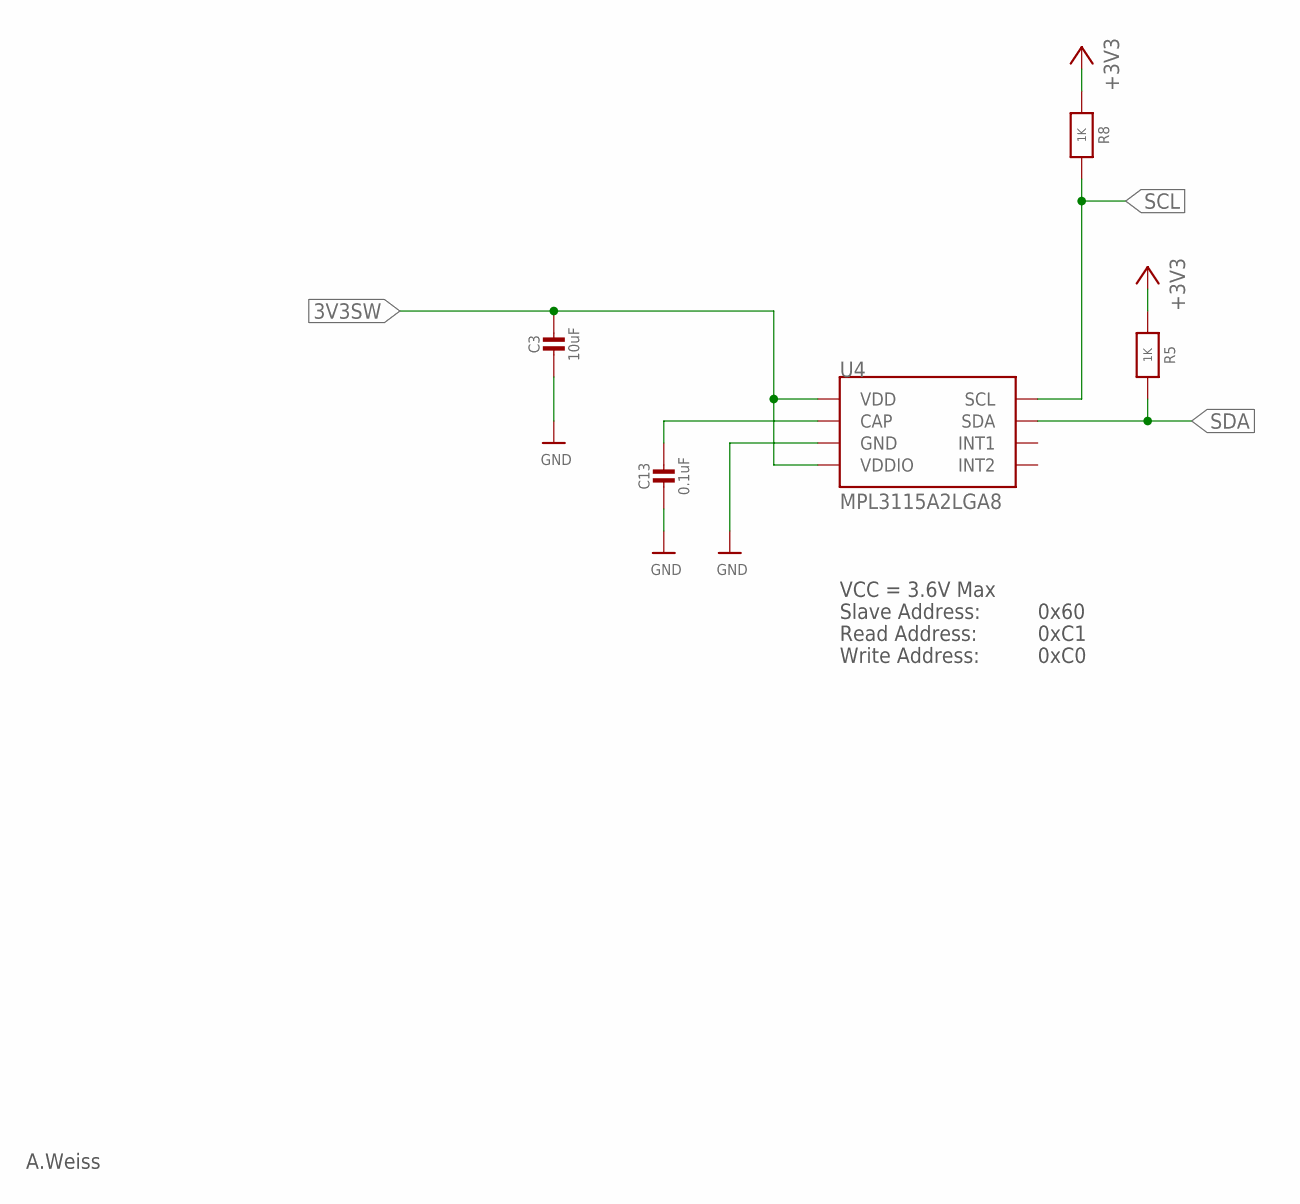
[picture p14: schematic Iridium_9603_Beacon_V5M.sch, sheet 4]

Parts:
C3: 10uF; 0805-NO
C13: 0.1uF; 0805-NO
R5, R8: 1K; 0603-NO
U4: MPL3115A2LGA8; LGA8

Connections:
3V3SW: C3.1, U4.1 (VDD), U4.4 (VDDIO); also elsewhere on the board
+3V3: R5.1, R8.1; also elsewhere on the board
GND: C3.2, C13.2, U4.3 (GND); also elsewhere on the board
unnamed: C13.1, U4.2 (CAP)
SCL: R8.2, U4.8 (SCL); also elsewhere on the board
SDA: R5.2, U4.7 (SDA); also elsewhere on the board

Notes on the sheet:
A.Weiss
VCC = 3.6V Max
Read Address:
Write Address:
Slave Address:
0x60
0xC1
0xC0

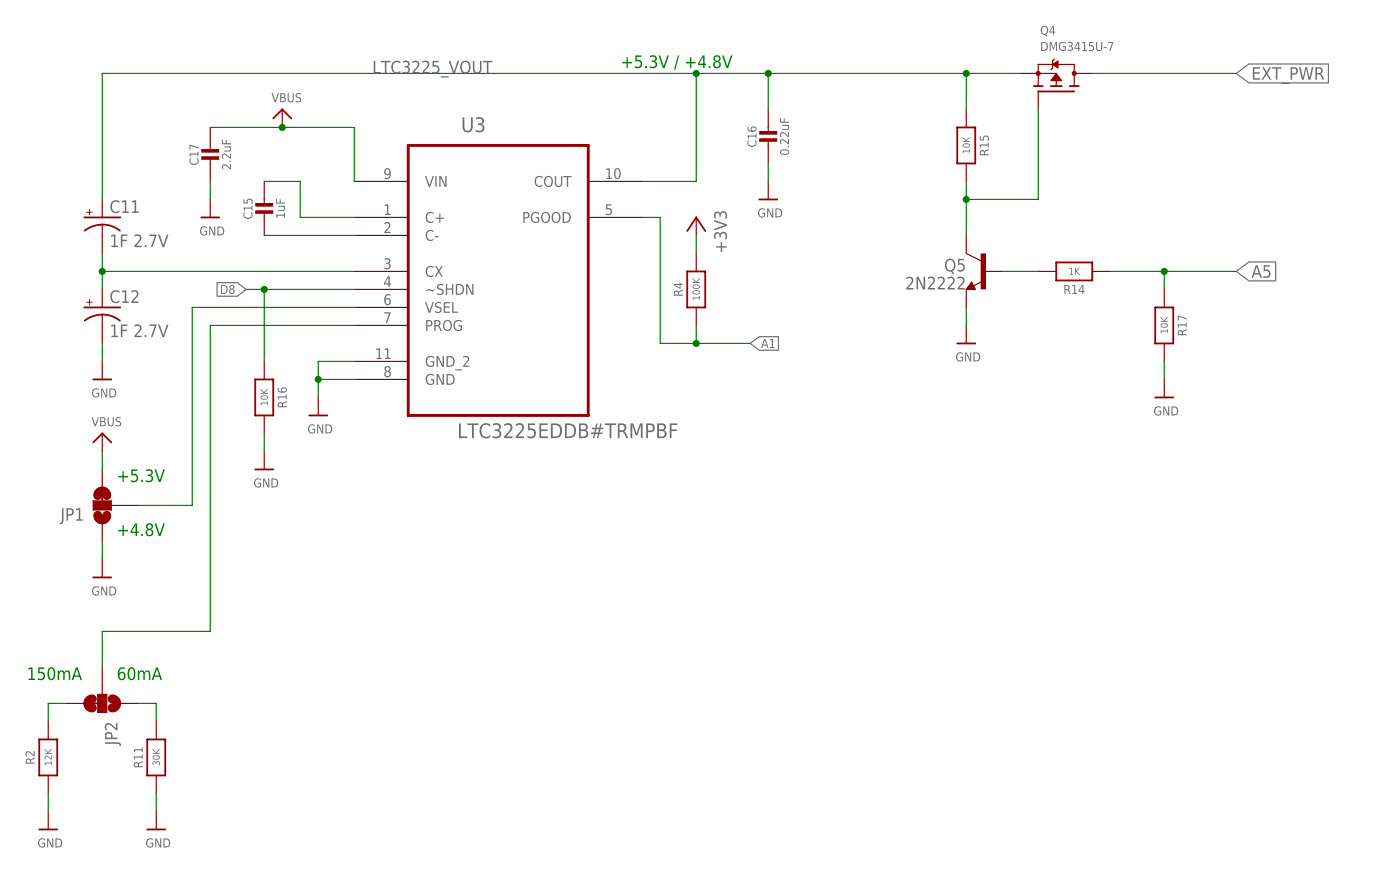
[picture p15: schematic Iridium_9603_Beacon_V5M.sch, sheet 5]

Parts:
C11, C12: 1F 2.7V; CPOL-RADIAL-1F-2.7V
C15: 1uF; 0603-NO
C16: 0.22uF; 0603-NO
C17: 2.2uF; 0805-NO
JP1, JP2: JUMPER-PAD-3-2OF3_NC_BY_TRACE_LARGE; PAD-JUMPER-3-2OF3_NC_BY_TRACE_YES_SILK_LARGE
Q4: DMG3415U-7; SOT23-WIDE
Q5: 2N2222; SOT23-BEC
R2: 12K; 0805-NO
R4: 100K; 0805-NO
R11: 30K; 0805-NO
R14: 1K; 0603-NO
R15, R16, R17: 10K; 0603-NO
U3: LTC3225EDDB#TRMPBF; DFN300X200-10L

Connections:
+3V3: R4.2; also elsewhere on the board
A1: R4.1, U3.5 (PGOOD); also elsewhere on the board
A5: R14.1, R17.1; also elsewhere on the board
D8: R16.1, U3.4 (~SHDN); also elsewhere on the board
EXT_PWR: Q4.3 (D); also elsewhere on the board
GND: C12.-, C16.2, C17.2, JP1.1, Q5.E, R2.1, R11.1, R16.2, R17.2, U3.8 (GND), U3.11 (GND_2); also elsewhere on the board
LTC3225_VOUT: C11.+, C16.1, Q4.2 (S), R15.1, U3.10 (COUT)
unnamed: C11.-, C12.+, U3.3 (CX)
unnamed: C15.2, U3.2 (C-)
unnamed: C15.1, U3.1 (C+)
unnamed: JP2.2, U3.7 (PROG)
unnamed: JP1.2, U3.6 (VSEL)
unnamed: JP2.3, R2.2
unnamed: JP2.1, R11.2
unnamed: Q4.1 (G), Q5.C, R15.2
unnamed: Q5.B, R14.2
VBUS: C17.1, JP1.3, U3.9 (VIN); also elsewhere on the board

Notes on the sheet:
+5.3V / +4.8V
+5.3V
+4.8V
150mA
60mA

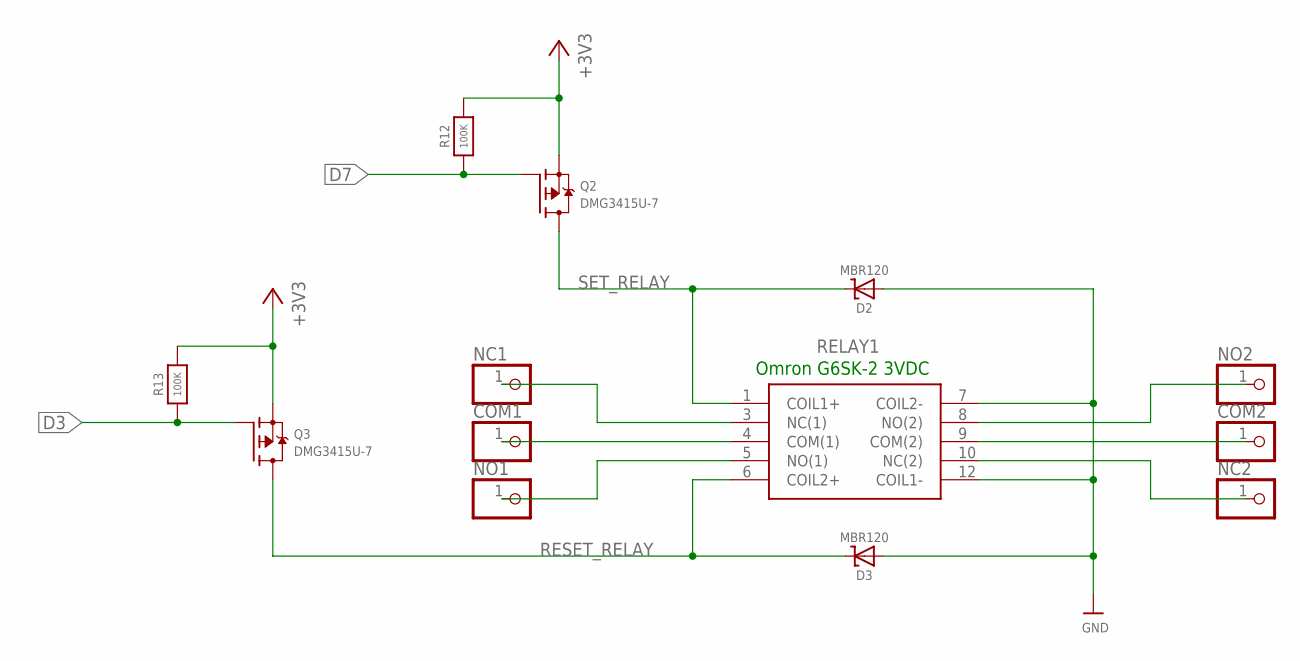
[picture p16: schematic Iridium_9603_Beacon_V5M.sch, sheet 6]

Parts:
COM1, COM2: PINHD-1X1; 1X01
D2, D3: MBR120; SOD-123
NC1, NC2: PINHD-1X1; 1X01
NO1, NO2: PINHD-1X1; 1X01
Q2, Q3: DMG3415U-7; SOT23-WIDE
R12, R13: 100K; 0805-NO
RELAY1: G6SK-2_DC5; G6SK2DC5

Connections:
+3V3: Q2.2 (S), Q3.2 (S), R12.2, R13.2; also elsewhere on the board
D3: Q3.1 (G), R13.1; also elsewhere on the board
D7: Q2.1 (G), R12.1; also elsewhere on the board
GND: D2.A, D3.A, RELAY1.7 (COIL2-), RELAY1.12 (COIL1-); also elsewhere on the board
unnamed: NC1.1, RELAY1.3 (NC(1))
unnamed: COM1.1, RELAY1.4 (COM(1))
unnamed: NO1.1, RELAY1.5 (NO(1))
unnamed: NO2.1, RELAY1.8 (NO(2))
unnamed: COM2.1, RELAY1.9 (COM(2))
unnamed: NC2.1, RELAY1.10 (NC(2))
RESET_RELAY: D3.C, Q3.3 (D), RELAY1.6 (COIL2+)
SET_RELAY: D2.C, Q2.3 (D), RELAY1.1 (COIL1+)

Notes on the sheet:
Omron G6SK-2 3VDC

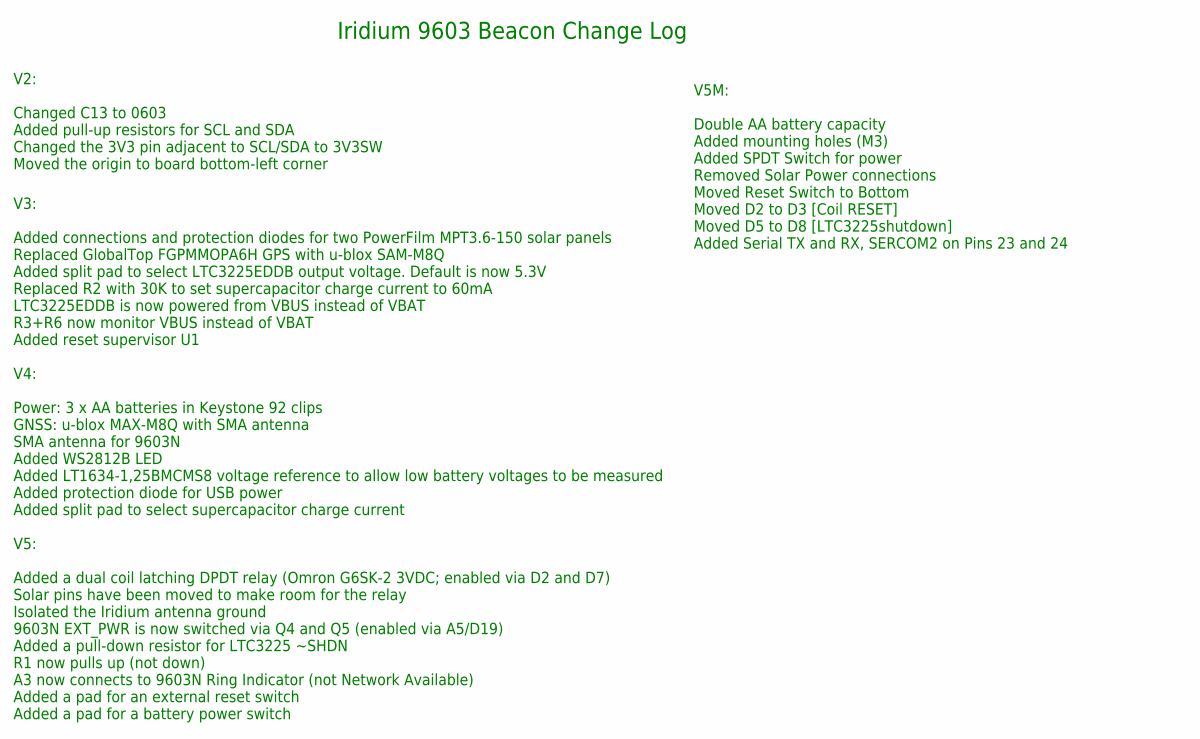
[picture p17: schematic Iridium_9603_Beacon_V5M.sch, sheet 7]

Notes on the sheet:
V2: Changed C13 to 0603 Added pull-up resistors for SCL and SDA Changed the 3V3 pin adjacent to SCL/SDA to 3V3SW Moved the origin to board bottom-left corner
Iridium 9603 Beacon Change Log
V3: Added connections and protection diodes for two PowerFilm MPT3.6-150 solar panels Replaced GlobalTop FGPMMOPA6H GPS with u-blox SAM-M8Q Added split pad to select LTC3225EDDB output voltage. Default is now 5.3V Replaced R2 with 30K to set supercapacitor charge current to 60mA LTC3225EDDB is now 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
V4: Power: 3 x AA batteries in Keystone 92 clips GNSS: u-blox MAX-M8Q with SMA antenna SMA antenna for 9603N Added WS2812B LED Added LT1634-1,25BMCMS8 voltage reference to allow low battery voltages to be measured Added protection diode for USB power Added split pad to select supercapacitor charge 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
V5: Added a dual coil latching DPDT relay (Omron G6SK-2 3VDC; enabled via D2 and D7) Solar pins have been moved to make room for the relay Isolated the Iridium antenna ground 9603N EXT_PWR is now switched via Q4 and Q5 (enabled via A5/D19) Added a pull-down resistor for LTC3225 ~SHDN R1 now pulls u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
V5M: Double AA battery capacity Added mounting holes (M3) Added SPDT Switch for power Removed Solar Power connections Moved Reset Switch to Bottom Moved D2 to D3 [Coil RESET] Moved D5 to D8 [LTC3225shutdown] Added Serial TX and RX, SERCOM2 on Pins 23 and 24

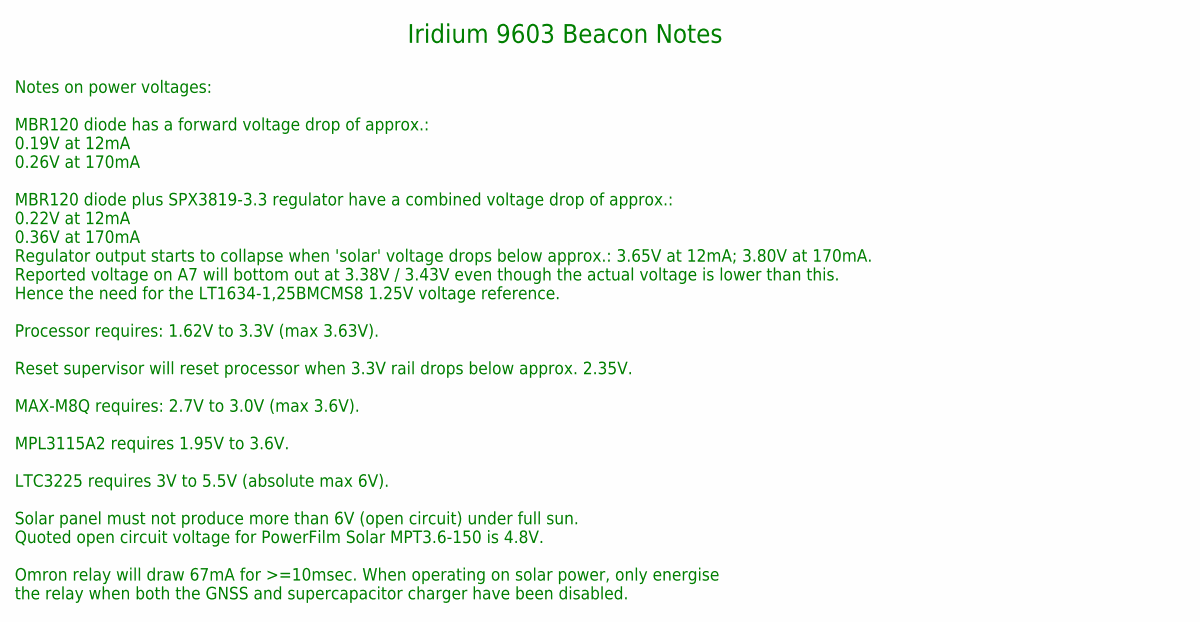
[picture p18: schematic Iridium_9603_Beacon_V5M.sch, sheet 8]

Notes on the sheet:
Iridium 9603 Beacon Notes
Notes on power voltages: MBR120 diode has a forward voltage drop of approx.: 0.19V at 12mA 0.26V at 170mA MBR120 diode plus SPX3819-3.3 regulator have a combined voltage drop of approx.: 0.22V at 12mA 0.36V at 170mA Regulator output starts to collapse when 'solar' voltage drops below approx.: 3.65V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

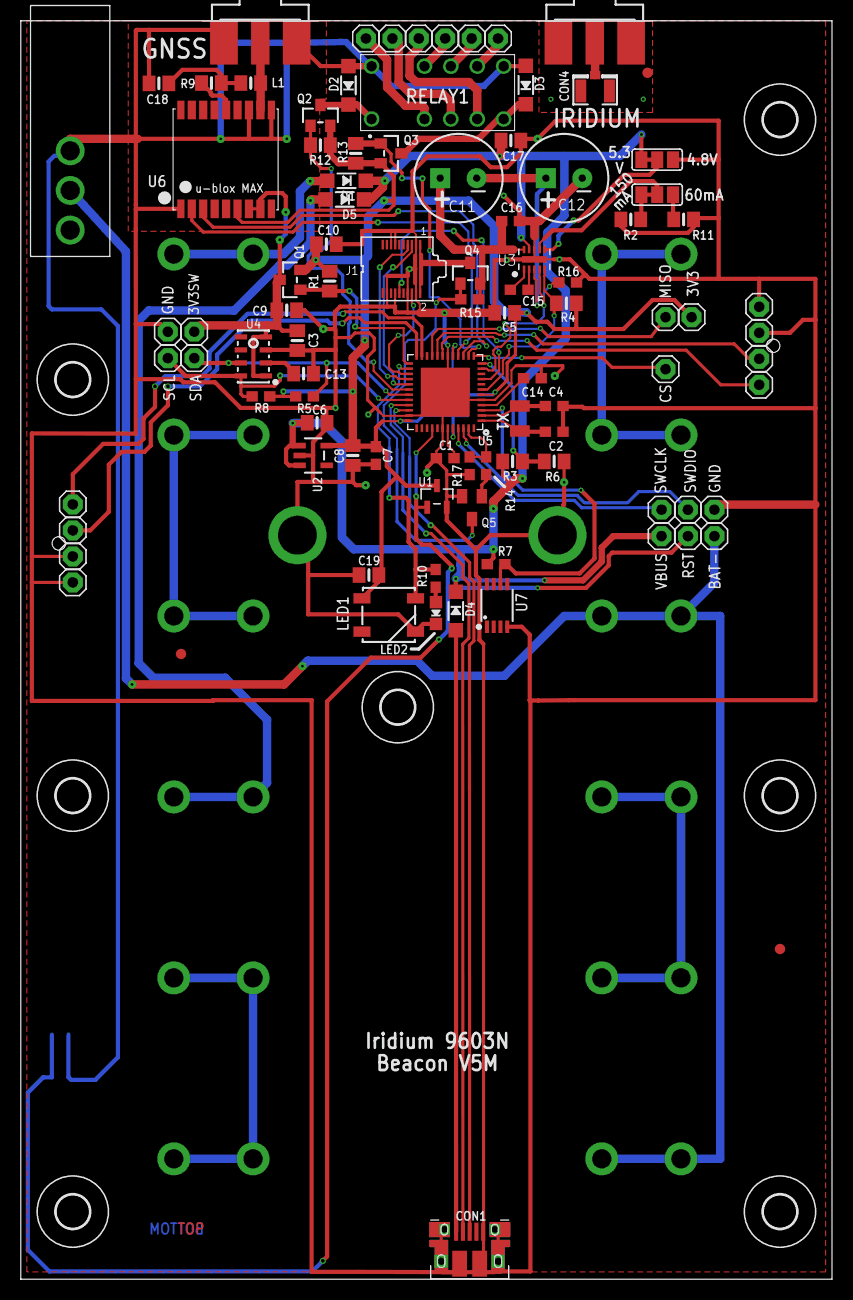
[picture p19: board Iridium_9603_Beacon_V5M.brd from above]

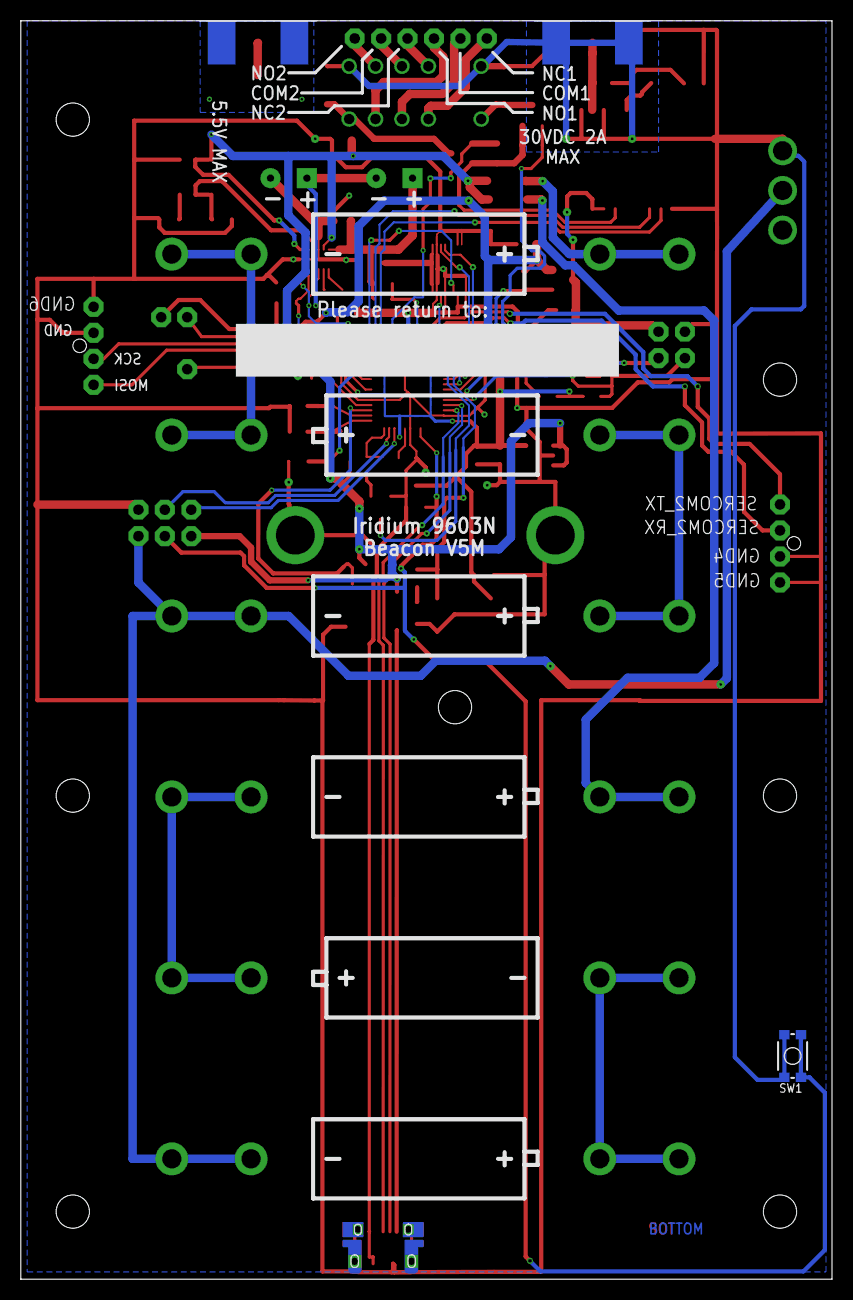
[picture p20: board Iridium_9603_Beacon_V5M.brd from below]

Board: 2 copper layers, 78.0 x 121.0 mm, 112 parts (7 on the bottom side), 70 nets.

Other parts of the board:
U$2, U$40, U$48, U$49, U$50, U$51, U$52: 3,2
