PaulLSK/Iridium_9603_Beacon/Arduino/Iridium9603NBeacon_V5M/Iridium9603NBeacon_V5M/Iridium9603NBeacon_V5M.ino

// ###########################
// # Iridium 9603N Beacon V5M #
// ###########################

int VERBOSE = 1; // 0 = OFF, 1 = ON

// !!!!!!!!!!!  MAKE SURE LOCALTEST and EMULATE ARE 0 FOR OPERATIONAL CODE !!!!!!!!!!!
int LOCALTEST = 1; //0 = OFF, 1 = ON (used for serial port functionality when you want to keep the serial monitor console open)
int EMULATE = 0; //0 = OFF, 1 = ON (used when not testing on an actual Beacon V5M board, i.e. Feather M0, Sparkfun ATSAMD21G)


// This version provides support for the iMET Radiosonde
// Radiosonde Pin# Tx (input) is connected to MOSI (Digital Pin 23, Port B Pin 10, SERCOM4 Pad 2, Serial3 Tx)
// Radiosonde Pin# Rx (output) is connected to SCK (Digital Pin 24, Port B Pin 11, SERCOM4 Pad 3, Serial3 Rx)

// Stores both source and destination RockBLOCK serial numbers in flash.
// The default values are:
#define RB_destination 0 // Serial number of the destination RockBLOCK (int). Set to zero to disable RockBLOCK message forwarding
#define RB_source 0 // Serial number of this unit (int)

// Updated for the V5 PCB: provides support for an OMRON G6SK relay; 9603N EXT_PWR is switched via a P-MOSFET.

// OMRON G6SK relay:
// Set coil is connected to D7 (pull low to energise the relay coil)

// --- Changed reset coil from D2 to D3 (prl) ----
// Reset coil is connected to D3 (pull low to energise the relay coil)

// The relay can be set/reset via an Iridium Mobile Terminated message (e.g. from RockBLOCK Operations or a Beacon Base) containing
// [RELAY=ON] or [RELAY=OFF]
// The relay can also be pulsed on (set) for 1-5 seconds via MT message containing
// [RELAY=1] or [RELAY=2] or [RELAY=3] or [RELAY=4] or [RELAY=5]

// Power for the 9603N is switched by a DMG3415 P-channel MOSFET
// A 2N2222 NPN transistor pulls the MOSFET gate low
// A high on A5 (D19) enables power to the 9603N

// Uses Cristian Maglie's FlashStorage library to store the BEACON_INTERVAL setting
// https://github.com/cmaglie/FlashStorage
// BEACON_INTERVAL can be updated via an Iridium Mobile Terminated message (e.g. from RockBLOCK Operations or a Beacon Base)

// Power can be provided by: two PowerFilm MPT3.6-150 solar panels; USB; 3 x Energiser Ultimate Lithium AA batteries
// GNSS data is provided by u-blox MAX-M8Q
// WB2812B NeoPixel is connected to D13 in parallel with a standard Red LED (for the bootloader)
// 1.25V precision voltage reference is connected to A0 to allow lower battery voltages to be measured

// With grateful thanks to Mikal Hart:
// Based on Mikal's IridiumSBD Beacon example: https://github.com/mikalhart/IridiumSBD
// Requires Mikal's TinyGPS library: https://github.com/mikalhart/TinyGPS
// and PString: http://arduiniana.org/libraries/pstring/

// With grateful thanks to:
// Adafruit: https://learn.adafruit.com/using-atsamd21-sercom-to-add-more-spi-i2c-serial-ports/creating-a-new-serial
// MartinL: https://forum.arduino.cc/index.php?topic=341054.msg2443086#msg2443086

// The Iridium_9603_Beacon PCB is based extensively on the Adafruit Feather M0 (Adalogger)
// https://www.adafruit.com/products/2796
// GPS data provided by u-blox MAX-M8Q
// https://www.u-blox.com/en/product/max-m8-series
// Pressure (altitude) and temperature provided by MPL3115A2
// Requires Adafruit's MPL3115A2 library
// https://github.com/adafruit/Adafruit_MPL3115A2_Library

// Support for the WB2812B is provided by Adafruit:
// https://github.com/adafruit/Adafruit_NeoPixel

// Uses RTCZero to provide sleep functionality (on the M0)
// https://github.com/arduino-libraries/RTCZero

// With grateful thanks to CaveMoa for his SimpleSleepUSB example
// https://github.com/cavemoa/Feather-M0-Adalogger
// https://github.com/cavemoa/Feather-M0-Adalogger/tree/master/SimpleSleepUSB
// Note: you will need to close and re-open your serial monitor each time the M0 wakes up

// With thanks to David A. Mellis and Tom Igoe for the smoothing tutorial
// http://www.arduino.cc/en/Tutorial/Smoothing

// Iridium 9603N is interfaced to M0 using Serial2
// D6 (Port A Pin 20) = Enable (Sleep) : Connect to 9603 ON/OFF Pin 5
// D10 (Port A Pin 18) = Serial2 TX : Connect to 9603 Pin 6
// D12 (Port A Pin 19) = Serial2 RX : Connect to 9603 Pin 7
// A3 / D17 (Port A Pin 4) = Ring Indicator : Connect to 9603 Pin 12

// Power to the 9603N is switched by a P-channel MOSFET
// The MOSFET gate is pulled high by a 10K resistor. The gate is pulled low by a 2N2222 NPN transistor
// Power is enabled by pulling the base of the transistor high
// The transistor base is connected to A5 / D19 (Port B Pin 2)

// Iridium 9603 is powered from Linear Technology LTC3225 SuperCapacitor Charger
// (fitted with 2 x 10F 2.7V caps e.g. Bussmann HV1030-2R7106-R)
// (or 2 x 1F 2.7V caps e.g. Bussmann HV0810-2R7105-R)
// to provide the 1.3A peak current when the 9603 is transmitting.
// Charging 10F capacitors to 5.3V at 60mA could take ~7 minutes!
// (~6.5 mins to PGOOD, ~7 mins to full charge)
// 1F capacitors charge in approx. 1/10 of that time.
// Setting the charging current to 150mA will reduce the time further.
// 5.3V is OK as the 9603N has an extended supply voltage range of +5 V +/- 0.5 V
// http://www.linear.com/product/LTC3225

// ---  V5M Changed Port Pin For LTC3225 ~Shutdown from D5 to D8 (prl) ---
// Original Port > D5 (Port A Pin 15) = LTC3225 ~Shutdown
// New Port > D8 (Port A Pin 06, Physical Pin 11) = LTC3225 ~Shutdown

// A1 / D15 (Port B Pin 8) = LTC3225 PGOOD

// MAX-M8Q GNSS is interfaced to M0 using Serial1
// D1 (Port A Pin 10) = Serial1 TX : Connect to GPS RX
// D0 (Port A Pin 11) = Serial1 RX : Connect to GPS TX
// D11 (Port A Pin 16) = GPS ENable : Connect to GPS EN(ABLE)

// MPL3115A2 Pressure (Altitude) and Temperature Sensor
// D20 (Port A Pin 22) = SDA : Connect to MPL3115A2 SDA
// D21 (Port A Pin 23) = SCL : Connect to MPL3115A2 SCL

// D13 (Port A Pin 17) = WB2812B NeoPixel + single Red LED
// D9 (Port A Pin 7) = AIN 7 : Bus Voltage / 2
// D14 (Port A Pin 2) = AIN 0 : 1.25V precision voltage reference

// D7 (Port A Pin 21) = OMRON relay set coil (pull low to energise the coil via a P-channel MOSFET)
// D3 (Port A Pin 09) = OMRON relay reset coil (pull low to energise the coil via a P-channel MOSFET)

// As the solar panel or battery voltage drops, reported VBUS on A7 drops to ~3.4V and then flatlines
// as the 3.3V rail starts to collapse. The 1.25V reference on A0 allows lower voltages to be measured
// as the signal on A0 will appear to _rise_ as the 3.3V rail collapses.

// Red LED on D13 shows when the SAMD is in bootloader mode (LED will fade up/down)

// WB2812B on D13 indicates what the software is doing:
// Magenta at power up (loop_step == init) (~10 seconds)
// Blue when waiting for a GNSS fix (loop_step == start_GPS or read_GPS or read_pressure) (could take 5 mins)
// Cyan when waiting for supercapacitors to charge (loop_step == start_LTC3225 or wait_LTC3225) (could take 7 mins)
// White during Iridium transmit (loop_step == start_9603) (could take 5 mins)
// Green flash (2 seconds) indicates successful transmission
// Red flash (2+ seconds) entering sleep
// LED will flash Red after: Iridium transmission (successful or failure); low battery detected; no GNSS data; supercapacitors failed to charge
// WB2812B blue LED has the highest forward voltage and is slightly dim at 3.3V. The red and green values are adapted accordingly (222 instead of 255).

// If you bought your 9603N from Rock7, you can have your messages delivered to another RockBLOCK automatically:
// https://www.rock7.com/shop-product-detail?productId=50
// http://www.rock7mobile.com/products-rockblock-9603
// http://www.rock7mobile.com/downloads/RockBLOCK-9603-Developers-Guide.pdf (see last page)
// Change RB_destination (above) to the serial number of the destination RockBLOCK
// Change RB_source (above) to the serial number of this RockBLOCK
// Both RBSOURCE and RBDESTINATION can be updated via a MT message.
// Note: the RockBLOCK gateway does not remove the destination RockBLOCK address from the SBD message
// so, in this code, it is included as a full CSV field

#include <IridiumSBD.h> // Requires V2: https://github.com/mikalhart/IridiumSBD
#include <TinyGPS.h> // NMEA parsing: http://arduiniana.org
#include <PString.h> // String buffer formatting: http://arduiniana.org

#include <Adafruit_NeoPixel.h> // Support for the WB2812B
#include "wiring_private.h"

#include <RTCZero.h> // M0 Real Time Clock
RTCZero rtc; // Create an rtc object

// ----- Changed BEACON_INTERVAL to SECONDS (V5 was in minutes) (prl) -----------------
// Define how often messages are sent in SECONDS (max 86400)
// This is the _quickest_ messages will be sent. Could be much slower than this depending on:
// capacitor charge time; gnss fix time; Iridium timeout; etc.
// The default value will be overwritten with the one stored in Flash - if one exists
// The value can be changed via a Mobile Terminated message
int BEACON_INTERVAL = 60;

// Flash Storage
#include <FlashStorage.h>
typedef struct { // Define a struct to hold the flash variable(s)
  int PREFIX; // Flash storage prefix (0xB5); used to test if flash has been written to before 
  int INTERVAL; // Message interval in minutes
  // RockBLOCK source serial number: stored as an int; i.e. the RockBLOCK serial number of the 9603N attached to this beacon
  int RBSOURCE; 
  // RockBLOCK destination serial number: stored as an int; i.e. the RockBLOCK serial number of the 9603N you would like the messages delivered _to_
  int RBDESTINATION; // Set this to zero to disable RockBLOCK gateway message forwarding
  int CSUM; // Flash storage checksum; the modulo-256 sum of PREFIX and INTERVAL; used to check flash data integrity
} FlashVarsStruct;
FlashStorage(flashVarsMem, FlashVarsStruct); // Reserve memory for the flash variables
FlashVarsStruct flashVars; // Define the global to hold the variables
int RBSOURCE = RB_source;
int RBDESTINATION = RB_destination;

// MPL3115A2
#include <Wire.h>
#include <Adafruit_MPL3115A2.h>
Adafruit_MPL3115A2 baro = Adafruit_MPL3115A2();

// Serial Port Definisions
// SERCOM0 -> Serial1 -> GPS
// SERCOM1 -> Serial2 -> Iridium
// SERCOM2 -> Serial4 -> DaisyChain [Enclosure Label SERIAL#1]
// SERCOM3 -> I2C -> PTU
// SERCOM4 -> Serial3 -> iMET [Enclosure Label SERIAL#2]
// SERCOM5 -> Serial -> USBSerial

// SERCOM1 -> Serial2 -> Iridium
// Serial2 pin and pad definitions (in Arduino files Variant.h & Variant.cpp)
#define PIN_SERIAL2_RX       (34ul)               // Pin description number for PIO_SERCOM on D12 (Physical Pin 28)
#define PIN_SERIAL2_TX       (36ul)               // Pin description number for PIO_SERCOM on D10 (Physical Pin 27)
#define PAD_SERIAL2_TX       (UART_TX_PAD_2)      // SERCOM1 pad 2 (SC1PAD2)
#define PAD_SERIAL2_RX       (SERCOM_RX_PAD_3)    // SERCOM1 pad 3 (SC1PAD3)
// Instantiate the Serial2 class
Uart Serial2(&sercom1, PIN_SERIAL2_RX, PIN_SERIAL2_TX, PAD_SERIAL2_RX, PAD_SERIAL2_TX);
HardwareSerial &ssIridium(Serial2);

// SERCOM4 -> Serial3 -> iMET
// Serial3 pin and pad definitions (in Arduino files Variant.h & Variant.cpp)
// iMET Tx  is connected to MOSI (Digital Pin 23, Port B Pin 10, SERCOM4 Pad 2, Serial3 Tx)
// iMET Rx  is connected to SCK (Digital Pin 24, Port B Pin 11, SERCOM4 Pad 3, Serial3 Rx)
#define PIN_SERIAL3_RX       (24ul)               // Pin description number for PIO_SERCOM on D24
#define PIN_SERIAL3_TX       (23ul)               // Pin description number for PIO_SERCOM on D23
#define PAD_SERIAL3_TX       (UART_TX_PAD_2)      // SERCOM4 Pad 2 (SC4PAD2)
#define PAD_SERIAL3_RX       (SERCOM_RX_PAD_3)    // SERCOM4 Pad 3 (SC4PAD3)
// Instantiate the Serial3 class
Uart Serial3(&sercom4, PIN_SERIAL3_RX, PIN_SERIAL3_TX, PAD_SERIAL3_RX, PAD_SERIAL3_TX);
HardwareSerial &ssiMET(Serial3);

// SERCOM2 -> Serial4 -> DaisyChain
// Serial4 pin and pad definitions (in Arduino files Variant.h & Variant.cpp)
// instrument Tx  is connected to  (Digital Pin 2, Port A Pin 14, SERCOM1 Pad 2, Serial4 Tx, Physical Pin 23)
// instrument Rx  is connected to (Digital Pin 5, Port A Pin 15, SERCOM1 Pad 3, Serial4 Rx, Physical Pin 24)
#define PIN_SERIAL4_RX       (5ul)               // Pin description number for PIO_SERCOM on D5
#define PIN_SERIAL4_TX       (2ul)               // Pin description number for PIO_SERCOM on D2
#define PAD_SERIAL4_TX       (UART_TX_PAD_2)      // SERCOM2 Pad 2 (SC2PAD2)
#define PAD_SERIAL4_RX       (SERCOM_RX_PAD_3)    // SERCOM2 Pad 3 (SC2PAD3)
// Instantiate the Serial3 class
Uart Serial4(&sercom2, PIN_SERIAL4_RX, PIN_SERIAL4_TX, PAD_SERIAL4_RX, PAD_SERIAL4_TX);
HardwareSerial &ssDaisyChain(Serial4);


// SERCOM0 -> Serial1 -> GPS
#define ssGPS Serial1 // Use M0 Serial1 to interface to the MAX-M8Q

// Leave the "#define GALILEO" uncommented to use: GPS + Galileo + GLONASS + SBAS
// Comment the "#define GALILEO" out to use the default u-blox M8 GNSS: GPS + SBAS + QZSS + GLONASS
#define GALILEO

// Set Nav Mode to Portable
static const uint8_t setNavPortable[] = {
  0xB5, 0x62, 0x06, 0x24, 0x24, 0x00, 0xFF, 0xFF, 0x00, 0x03, 0x00, 0x00, 0x00, 0x00, 0x10, 0x27, 0x00, 0x00, 
  0x05, 0x00, 0xFA, 0x00, 0xFA, 0x00, 0x64, 0x00, 0x2C, 0x01, 0x00, 0x00, 0x00, 0x00, 0x00, 0x00, 0x00, 0x00, 
  0x00, 0x00, 0x00, 0x00, 0x00, 0x00 };

// Set Nav Mode to Pedestrian
static const uint8_t setNavPedestrian[] = {
  0xB5, 0x62, 0x06, 0x24, 0x24, 0x00, 0xFF, 0xFF, 0x03, 0x03, 0x00, 0x00, 0x00, 0x00, 0x10, 0x27, 0x00, 0x00, 
  0x05, 0x00, 0xFA, 0x00, 0xFA, 0x00, 0x64, 0x00, 0x2C, 0x01, 0x00, 0x00, 0x00, 0x00, 0x00, 0x00, 0x00, 0x00, 
  0x00, 0x00, 0x00, 0x00, 0x00, 0x00 };

// Set Nav Mode to Automotive
static const uint8_t setNavAutomotive[] = {
  0xB5, 0x62, 0x06, 0x24, 0x24, 0x00, 0xFF, 0xFF, 0x04, 0x03, 0x00, 0x00, 0x00, 0x00, 0x10, 0x27, 0x00, 0x00, 
  0x05, 0x00, 0xFA, 0x00, 0xFA, 0x00, 0x64, 0x00, 0x2C, 0x01, 0x00, 0x00, 0x00, 0x00, 0x00, 0x00, 0x00, 0x00, 
  0x00, 0x00, 0x00, 0x00, 0x00, 0x00 };

// Set Nav Mode to Sea
static const uint8_t setNavSea[] = {
  0xB5, 0x62, 0x06, 0x24, 0x24, 0x00, 0xFF, 0xFF, 0x05, 0x03, 0x00, 0x00, 0x00, 0x00, 0x10, 0x27, 0x00, 0x00, 
  0x05, 0x00, 0xFA, 0x00, 0xFA, 0x00, 0x64, 0x00, 0x2C, 0x01, 0x00, 0x00, 0x00, 0x00, 0x00, 0x00, 0x00, 0x00, 
  0x00, 0x00, 0x00, 0x00, 0x00, 0x00 };

// Set Nav Mode to Airborne <1G
static const uint8_t setNavAir[] = {
  0xB5, 0x62, 0x06, 0x24, 0x24, 0x00, 0xFF, 0xFF, 0x06, 0x03, 0x00, 0x00, 0x00, 0x00, 0x10, 0x27, 0x00, 0x00, 
  0x05, 0x00, 0xFA, 0x00, 0xFA, 0x00, 0x64, 0x00, 0x2C, 0x01, 0x00, 0x00, 0x00, 0x00, 0x00, 0x00, 0x00, 0x00, 
  0x00, 0x00, 0x00, 0x00, 0x00, 0x00 };

static const int len_setNav = 42;

// Set NMEA Config
// Set trackFilt to 1 to ensure course (COG) is always output
// Set Main Talker ID to 'GP' to avoid having to modify TinyGPS
static const uint8_t setNMEA[] = {
  0xb5, 0x62, 0x06, 0x17, 0x14, 0x00, 0x20, 0x40, 0x00, 0x02, 0x00, 0x00, 0x00, 0x00, 0x00, 0x01, 0x01, 0x01,
  0x00, 0x00, 0x00, 0x00, 0x00, 0x00, 0x00, 0x00 };
static const int len_setNMEA = 26;

// Set GNSS Config to GPS + Galileo + GLONASS + SBAS (Causes the M8 to restart!)
static const uint8_t setGNSS[] = {
  0xb5, 0x62, 0x06, 0x3e, 0x3c, 0x00,
  0x00, 0x20, 0x20, 0x07,
  0x00, 0x08, 0x10, 0x00, 0x01, 0x00, 0x01, 0x01,
  0x01, 0x01, 0x03, 0x00, 0x01, 0x00, 0x01, 0x01,
  0x02, 0x04, 0x08, 0x00, 0x01, 0x00, 0x01, 0x01,
  0x03, 0x08, 0x10, 0x00, 0x00, 0x00, 0x01, 0x01,
  0x04, 0x00, 0x08, 0x00, 0x00, 0x00, 0x01, 0x03,
  0x05, 0x00, 0x03, 0x00, 0x00, 0x00, 0x01, 0x05,
  0x06, 0x08, 0x0e, 0x00, 0x01, 0x00, 0x01, 0x01 };
static const int len_setGNSS = 66;

static const int ringIndicator = 17; // 9602 Ring Indicator on pin D17
static const int LTC3225shutdown = 8; // LTC3225 ~Shutdown on pin D8
static const int LTC3225PGOOD = 15; // LTC3225 PGOOD on pin A1 / D15
static const int Enable_9603N = 19; // 9603N Enable (enables EXT_PWR via P-MOSFET)
static const int IridiumSleepPin = 6; // Iridium Sleep connected to D6
IridiumSBD isbd(ssIridium, IridiumSleepPin); // This should disable the 9603
TinyGPS tinygps;
long iterationCounter = 0; // Increment each time a transmission is attempted

static const int ledPin = 13; // WB2812B + Red LED on pin D13

//#define NoLED // Uncomment this line to disable the LED
#define swap_red_green // Uncomment this line if your WB2812B has red and green reversed
#ifdef swap_red_green
  Adafruit_NeoPixel pixels = Adafruit_NeoPixel(1, ledPin, NEO_GRB + NEO_KHZ800); // GRB WB2812B
#else
  Adafruit_NeoPixel pixels = Adafruit_NeoPixel(1, ledPin, NEO_RGB + NEO_KHZ800); // RGB WB2812B
#endif
#define LED_Brightness 32 // 0 - 255 for WB2812B

static const int GPS_EN = 11; // GPS & MPL3115A2 Enable on pin D11
#define GPS_ON LOW
#define GPS_OFF HIGH
#define VAP A7 // Bus voltage analog pin (bus voltage divided by 2)
#define VREF A0 // 1.25V precision voltage reference
#define VBUS_NORM 3.3 // Normal bus voltage for battery voltage calculations
#define VREF_NORM 1.25 // Normal reference voltage for battery voltage calculations
#define VBAT_LOW 3.05 // Minimum voltage for LTC3225

static const int set_coil = 7; // OMRON G6SK relay set coil (pull low to energise coil)
static const int reset_coil = 3; // OMRON G6SK relay reset coil (pull low to energise coil) [D3]

// Loop Steps
#define init            0
#define start_GPS       1
#define read_GPS        2
#define read_pressure   3
#define read_DaisyChain 4
#define start_iMET       5
#define start_LTC3225   6
#define wait_LTC3225    7
#define start_9603      8
#define zzz             9
#define wake            10


// Variables used by Loop
int year;
byte month, day, hour, minute, second, hundredths;
unsigned long dateFix, locationFix;
float latitude, longitude;
long altitude;
float speed;
short satellites;
long course;
long hdop;
bool fixFound = false;
bool charsSeen = false;
int loop_step = init;
float vbat = 5.3;
float vref = VREF_NORM;
float vrail = VBUS_NORM;
float pascals, tempC;
int PGOOD;
unsigned long tnow;
bool reset_relay_flag = false;
bool set_relay_flag = false;
bool pulse_relay_flag = false;
int relay_pulse_duration = 0;
String iMET_Xdata = "";
int ssiMET_AvailableBytes = 0;
String DaisyChain_Xdata = "";
int ssDaisyChain_AvailableBytes = 0;

char DaisyChainBuffer[65];
char iMETBuffer[15];

// Storage for the average voltage during Iridium callbacks
const int numReadings = 25;   // number of samples
int readings[numReadings];    // the readings from the analog input
int readIndex = 0;            // the index of the current reading
long int total = 0;           // the running total
int latest_reading = 0;       // the latest reading
int average_reading = 0;      // the average reading

// IridiumSBD Callbacks
bool ISBDCallback()
{
#ifndef NoLED
  // 'Flash' the LED
  if ((millis() / 1000) % 2 == 1) {
    LED_dim_white();
  }
  else {
    LED_white();
  }
#endif

  // Check the 'battery' voltage now we are drawing current for the 9603
  // If voltage is low, stop Iridium send
  // Average voltage over numReadings to smooth out any short dips

  // Measure the reference voltage and calculate the rail voltage
  vref = analogRead(VREF) * (VBUS_NORM / 1023.0);
  vrail = VREF_NORM * VBUS_NORM / vref;

  // subtract the last reading:
  total = total - readings[readIndex];
  // read from the sensor:
  latest_reading = analogRead(VAP);
  readings[readIndex] = latest_reading;
  // add the reading to the total:
  total = total + latest_reading;
  // advance to the next position in the array:
  readIndex = readIndex + 1;
  // if we're at the end of the array...wrap around to the beginning:
  if (readIndex >= numReadings) readIndex = 0;
  // calculate the average:
  average_reading = total / numReadings; // Seems to work OK with integer maths - but total does need to be long int
  vbat = float(average_reading) * (2.0 * vrail / 1023.0); // Calculate average battery voltage using corrected rail voltage
  if (EMULATE) {vbat = 3.3;}
  
  if (vbat < VBAT_LOW) {
    Serial.print("[ERROR : ISBDCallback] ***!!! LOW VOLTAGE (ISBDCallback) ");
    Serial.print(vbat,2);
    Serial.println("V !!!***");
    return false; // Returning false causes IridiumSBD to terminate
  }
  else {     
    return true;
  }
}
// V2 console and diagnostic callbacks (replacing attachConsole and attachDiags)
void ISBDConsoleCallback(IridiumSBD *device, char c) { Serial.write(c); }
void ISBDDiagsCallback(IridiumSBD *device, char c) { Serial.write(c); }

// Interrupt handler for SERCOM1 (essential for Serial2 comms)
void SERCOM1_Handler()
{
  Serial2.IrqHandler();
}

// Interrupt handler for SERCOM4 (essential for Serial3 comms)
void SERCOM4_Handler()
{
  Serial3.IrqHandler();
}

// Interrupt handler for SERCOM4 (essential for Serial4 comms)
void SERCOM2_Handler()
{
  Serial4.IrqHandler();
}


// RTC alarm interrupt
void alarmMatch()
{
  int rtc_seconds = rtc.getSeconds();
  int rtc_mins = rtc.getMinutes(); // Read the RTC minutes
  int rtc_hours = rtc.getHours(); // Read the RTC hours


  if (VERBOSE) {
    Serial.print("[INFO : alarmMatch] Current Time: ");
    print2digits(rtc_hours);
    Serial.print(":");
    print2digits(rtc_mins);
    Serial.print(":");
    print2digits(rtc_seconds);   
    Serial.println();
  }

  
  if (BEACON_INTERVAL > 86400) BEACON_INTERVAL = 86400; // Limit BEACON_INTERVAL to one day, value in seconds
  rtc_seconds = rtc_seconds + BEACON_INTERVAL; // Add the BEACON_INTERVAL to the RTC seconds
  while (rtc_seconds >= 60) { // If there has been a minute roll over
    rtc_seconds = rtc_seconds - 60; // Subtract 60 seconds
    rtc_mins = rtc_mins + 1; // Add a minute
  }

  while (rtc_mins >= 60) { // If there has been an hour roll over
    rtc_mins = rtc_mins - 60; // Subtract 60 minutes
    rtc_hours = rtc_hours + 1; // Add an hour
  }
  
  rtc_hours = rtc_hours % 24; // Check for a day roll over

  if (VERBOSE) {
    Serial.print("[INFO : alarmMatch] Next Alarm Time: ");
    print2digits(rtc_hours);
    Serial.print(":");
    print2digits(rtc_mins);
    Serial.print(":");
    print2digits(rtc_seconds);   
    Serial.println();
  }

  rtc.setAlarmSeconds(rtc_seconds);
  rtc.setAlarmMinutes(rtc_mins); // Set next alarm time (minutes)
  rtc.setAlarmHours(rtc_hours); // Set next alarm time (hours)
}

// Read 'battery' voltage
void get_vbat() {
  // Measure the reference voltage and calculate the rail voltage
  vref = analogRead(VREF) * (VBUS_NORM / 1023.0);
  vrail = VREF_NORM * VBUS_NORM / vref;

  vbat = analogRead(VAP) * (2.0 * vrail / 1023.0); // Read 'battery' voltage from resistor divider, correcting for vrail

  // MAKE SURE LOCALTEST = 0 FOR OPERATIONAL CODE
  if (EMULATE) { vbat = 3.3; }
}

void LED_off() // Turn NeoPixel off
{
  pixels.setPixelColor(0,0,0,0);
  pixels.show();
}

void LED_dim_white() // Set LED to dim white
{
  pixels.setBrightness(LED_Brightness / 2); // Dim the LED brightness
  pixels.setPixelColor(0, pixels.Color(222,222,255)); // Set color.
  pixels.show(); // This sends the updated pixel color to the hardware.
  pixels.setBrightness(LED_Brightness); // Reset the LED brightness
}

void LED_dim_blue() // Set LED to dim blue
{
  pixels.setBrightness(LED_Brightness / 2); // Dim the LED brightness
  pixels.setPixelColor(0, pixels.Color(0,0,255)); // Set color.
  pixels.show(); // This sends the updated pixel color to the hardware.
  pixels.setBrightness(LED_Brightness); // Reset the LED brightness
}

void LED_dim_cyan() // Set LED to dim cyan
{
  pixels.setBrightness(LED_Brightness / 2); // Dim the LED brightness
  pixels.setPixelColor(0, pixels.Color(0,222,255)); // Set color.
  pixels.show(); // This sends the updated pixel color to the hardware.
  pixels.setBrightness(LED_Brightness); // Reset the LED brightness
}

void LED_white() // Set LED to white
{
  pixels.setPixelColor(0, pixels.Color(222,222,255)); // Set color.
  pixels.show(); // This sends the updated pixel color to the hardware.
}

void LED_red() // Set LED to red
{
  pixels.setPixelColor(0, pixels.Color(222,0,0)); // Set color.
  pixels.show(); // This sends the updated pixel color to the hardware.
}

void LED_green() // Set LED to green
{
  pixels.setPixelColor(0, pixels.Color(0,222,0)); // Set color.
  pixels.show(); // This sends the updated pixel color to the hardware.
}

void LED_blue() // Set LED to blue
{
  pixels.setPixelColor(0, pixels.Color(0,0,255)); // Set color.
  pixels.show(); // This sends the updated pixel color to the hardware.
}

void LED_cyan() // Set LED to cyan
{
  pixels.setPixelColor(0, pixels.Color(0,222,255)); // Set color.
  pixels.show(); // This sends the updated pixel color to the hardware.
}

void LED_magenta() // Set LED to magenta
{
  pixels.setPixelColor(0, pixels.Color(222,0,255)); // Set color.
  pixels.show(); // This sends the updated pixel color to the hardware.
}

// Send message in u-blox UBX format
// Calculates and appends the two checksum bytes
// Doesn't add the 0xb5 and 0x62 sync chars (these need to be included at the start of the message)
void sendUBX(const uint8_t *message, const int len) {
  int csum1 = 0; // Checksum bytes
  int csum2 = 0;
  for (int i=0; i<len; i++) { // For each byte in the message
    ssGPS.write(message[i]); // Write the byte
    if (i >= 2) { // Don't include the sync chars in the checksum
      csum1 = csum1 + message[i]; // Update the checksum bytes
      csum2 = csum2 + csum1;
    }
  }
  csum1 = csum1 & 0xff; // Limit checksums to 8-bits
  csum2 = csum2 & 0xff;
  ssGPS.write((uint8_t)csum1); // Send the checksum bytes
  ssGPS.write((uint8_t)csum2);
}

void set_relay()
{
  pinMode(set_coil, OUTPUT); // Make relay set_coil pin an output
  digitalWrite(set_coil, LOW); // Pull pin low
  delay(20); // Pull pin low for 20msec
  digitalWrite(set_coil, HIGH); // Pull pin high again
  pinMode(set_coil, INPUT_PULLUP); // Make relay set_coil pin high-impedance 
}

void reset_relay()
{
  pinMode(reset_coil, OUTPUT); // Make relay reset_coil pin an output
  digitalWrite(reset_coil, LOW); // Pull pin low
  delay(20); // Pull pin low for 20msec
  digitalWrite(reset_coil, HIGH); // Pull pin high again
  pinMode(reset_coil, INPUT_PULLUP); // Make relay reset_coil pin high-impedance 
}

void print2digits(int number) {
  if (number < 10) {
    Serial.print("0"); // print a 0 before if the number is < than 10
  }
  Serial.print(number);
}

void setup()
{

  if (LOCALTEST) {
    // ONLY FOR TESTING
    //  Putting serial here keeps console alive during loop
    // Start the serial console
    Serial.begin(115200);
    delay(10000); // Wait 10 secs - allow time for user to open serial monitor
    Serial.println("[INFO : setup] INIT - START SERIAL - !! CHANGE LOCALTEST to 0 For OPERATIONAL !!");
  }
  
  
  pinMode(LTC3225shutdown, OUTPUT); // LTC3225 supercapacitor charger shutdown pin
  digitalWrite(LTC3225shutdown, LOW); // Disable the LTC3225 supercapacitor charger
  pinMode(LTC3225PGOOD, INPUT); // Define an input for the LTC3225 Power Good signal
  
  pinMode(Enable_9603N, OUTPUT); // 9603N enable via P-FET and NPN transistor
  digitalWrite(Enable_9603N, LOW); // Disable the 9603N
  
  pinMode(GPS_EN, OUTPUT); // GPS & MPL3115A2 enable
  digitalWrite(GPS_EN, GPS_OFF); // Disable the GPS and MPL3115A2
  
  pinMode(IridiumSleepPin, OUTPUT); // The call to IridiumSBD should have done this - but just in case
  digitalWrite(IridiumSleepPin, LOW); // Disable the Iridium 9603
  pinMode(ringIndicator, INPUT); // Define an input for the Iridium 9603 Ring Indicator signal

  pinMode(set_coil, INPUT_PULLUP); // Initialise relay set_coil pin
  pinMode(reset_coil, INPUT_PULLUP); // Initialise relay reset_coil pin

  pixels.begin(); // This initializes the NeoPixel library.
  delay(100); // Seems necessary to make the NeoPixel start reliably 
  pixels.setBrightness(LED_Brightness); // Initialize the LED brightness
  LED_off(); // Turn NeoPixel off
#ifndef NoLED
  LED_magenta(); // Set LED to Magenta
#endif
  
  // See if global variables have already been stored in flash
  // If they have, read them. If not, initialise them.
  flashVars = flashVarsMem.read(); // Read the flash memory
  int csum = flashVars.PREFIX + flashVars.INTERVAL + flashVars.RBSOURCE + flashVars.RBDESTINATION; // Sum the prefix and data
  csum = csum & 0xff; // Limit checksum to 8-bits
  if ((flashVars.PREFIX == 0xB5) and (csum == flashVars.CSUM)) { // Check prefix and checksum match
    // Flash data is valid so update globals using the stored values
    BEACON_INTERVAL = flashVars.INTERVAL;
    RBSOURCE = flashVars.RBSOURCE;
    RBDESTINATION = flashVars.RBDESTINATION;
  }
  else {
    // Flash data is corrupt or hasn't been initialised so do that now
    flashVars.PREFIX = 0xB5; // Initialise the prefix
    flashVars.INTERVAL = BEACON_INTERVAL; // Initialise the beacon interval
    flashVars.RBSOURCE = RBSOURCE; // Initialise the source RockBLOCK serial number
    flashVars.RBDESTINATION = RBDESTINATION; // Initialise the destination RockBLOCK serial number
    csum = flashVars.PREFIX + flashVars.INTERVAL + flashVars.RBSOURCE + flashVars.RBDESTINATION; // Initialise the checksum
    csum = csum & 0xff;
    flashVars.CSUM = csum;
    flashVarsMem.write(flashVars); // Write the flash variables
    reset_relay(); // Reset the relay as this is the first time the code has been run
  }

  rtc.begin(); // Start the RTC now that BEACON_INTERVAL has been updated
  alarmMatch(); // Set next alarm time using updated BEACON_INTERVAL
  rtc.enableAlarm(rtc.MATCH_HHMMSS); // Alarm Match on hours, minutes and seconds
  rtc.attachInterrupt(alarmMatch); // Attach alarm interrupt
  
  iterationCounter = 0; // Make sure iterationCounter is set to zero (indicating a reset)
  loop_step = init; // Make sure loop_step is set to init

  // Initialise voltage sample buffer to 5.3V
  for (int thisReading = 0; thisReading < numReadings; thisReading++) {
    readings[thisReading] = 822; // 5.3V * 1023 / (2 * 3.3)
  }
  total = numReadings * 822;
  vbat = 5.3;
}


void loop()
{
  unsigned long loopStartTime = millis();

  switch(loop_step) {

    case init:

#ifndef NoLED
      LED_magenta(); // Set LED to Magenta
#endif

      if (!LOCALTEST) {        
        // Start the serial console
        Serial.begin(115200);
        delay(10000); // Wait 10 secs - allow time for user to open serial monitor
        Serial.println("[INFO : init] INIT - START SERIAL");
      }
    
      // Send welcome message
      Serial.print("[INFO : init] INIT - Iridium 9603N Beacon V5M at ");
      // --------  Print date... ----------
      print2digits(rtc.getDay());
      Serial.print("/");
      print2digits(rtc.getMonth());
      Serial.print("/");
      print2digits(rtc.getYear());
      Serial.print(" ");
      // ...and time
      print2digits(rtc.getHours());
      Serial.print(":");
      print2digits(rtc.getMinutes());
      Serial.print(":");
      print2digits(rtc.getSeconds());
      Serial.println();
      // ---------  end print time -------------

      // Echo VERBOSE, LOCALTEST and EMULATE setting
      Serial.print("[INFO : init] VERBOSE = "); Serial.print(VERBOSE); Serial.print(" LOCALTEST = "); Serial.print(LOCALTEST); Serial.print(" EMULATE = "); Serial.println(EMULATE);
      if (LOCALTEST or EMULATE) {Serial.println("[WARNING : init] LOCALTEST and/or EMULATE is set to TRUE");}

      // Echo the BEACON_INTERVAL
      Serial.print("[INFO : init] Using a BEACON_INTERVAL of ");
      Serial.print(BEACON_INTERVAL);
      Serial.println(" SECONDS");
      
      // Echo RBDESTINATION and RBSOURCE
      Serial.print("[INFO : init] Using an RBDESTINATION of ");
      Serial.println(RBDESTINATION);
      Serial.print("[INFO : init] Using an RBSOURCE of ");
      Serial.println(RBSOURCE);

      // Setup the IridiumSBD
      // (attachConsole and attachDiags methods have been replaced with ISBDConsoleCallback and ISBDDiagsCallback)
      isbd.setPowerProfile(IridiumSBD::USB_POWER_PROFILE); // Change power profile to "low current"
      isbd.useMSSTMWorkaround(false); // Redundant?

      // Check battery voltage
      // If voltage is low, go to sleep
      get_vbat();
      if (vbat < VBAT_LOW) {
        Serial.print("[ERROR : init] ***!!! LOW VOLTAGE (init) ");
        Serial.print(vbat,2);
        Serial.println(" !!!***");
        loop_step = zzz;
      }
      else {
        loop_step = start_GPS;
      }
      
      break;
      
    case start_GPS:

#ifndef NoLED
      LED_blue(); // Set LED to Blue
#endif
    
      // Power up the GPS and MPL3115A2
      Serial.println("[INFO : start_GPS] Powering up the GPS and MPL3115A2...");
      digitalWrite(GPS_EN, GPS_ON); // Enable the GPS and MPL3115A2

      delay(2000); // Allow time for both to start
    
      // Check battery voltage now we are drawing current for the GPS
      // If voltage is low, go to sleep
      get_vbat();
      if (vbat < VBAT_LOW) {
        Serial.print("[ERROR : start_GPS] ***!!! LOW VOLTAGE (start_GPS) ");
        Serial.print(vbat,2);
        Serial.println("V !!!***");
        loop_step = zzz;
      }
      else {
        loop_step = read_GPS;
      }
      
      break;

    case read_GPS:
      // Start the GPS serial port
      ssGPS.begin(9600);

      delay(1000); // Allow time for the port to open

      // Configure GPS
      Serial.println("[INFO : read_GPS] Configuring GPS...");

      // Disable all messages except GGA and RMC
      ssGPS.println("$PUBX,40,GLL,0,0,0,0*5C"); // Disable GLL
      delay(1100);
      ssGPS.println("$PUBX,40,ZDA,0,0,0,0*44"); // Disable ZDA
      delay(1100);
      ssGPS.println("$PUBX,40,VTG,0,0,0,0*5E"); // Disable VTG
      delay(1100);
      ssGPS.println("$PUBX,40,GSV,0,0,0,0*59"); // Disable GSV
      delay(1100);
      ssGPS.println("$PUBX,40,GSA,0,0,0,0*4E"); // Disable GSA
      delay(1100);
      
      //sendUBX(setNavPortable, len_setNav); // Set Portable Navigation Mode
      //sendUBX(setNavPedestrian, len_setNav); // Set Pedestrian Navigation Mode
      //sendUBX(setNavAutomotive, len_setNav); // Set Automotive Navigation Mode
      //sendUBX(setNavSea, len_setNav); // Set Sea Navigation Mode
      sendUBX(setNavAir, len_setNav); // Set Airborne <1G Navigation Mode
      delay(1100);

      sendUBX(setNMEA, len_setNMEA); // Set NMEA: to always output COG; and set main talker to GP (instead of GN)
      delay(1100);

#ifdef GALILEO
      sendUBX(setGNSS, len_setGNSS); // Set GNSS - causes M8 to restart!
      delay(3000); // Wait an extra time for GNSS to restart
#endif

      while(ssGPS.available()){ssGPS.read();} // Flush RX buffer so we don't confuse TinyGPS with UBX acknowledgements

      // Reset TinyGPS and begin listening to the GPS
      Serial.println("[INFO : read_GPS] Beginning to listen for GPS traffic...");
      fixFound = false; // Reset fixFound
      charsSeen = false; // Reset charsSeen
      tinygps = TinyGPS();
      
      // Look for GPS signal for up to 5 minutes
      //for (tnow = millis(); !fixFound && millis() - tnow < 5UL * 60UL * 1000UL;)
      for (tnow = millis(); !fixFound && millis() - tnow < 1UL * 6UL * 1000UL;)  // !!!!  Change this !!!!!
      {
        if (ssGPS.available())
        {
          charsSeen = true;
          if (tinygps.encode(ssGPS.read()))
          {
            tinygps.f_get_position(&latitude, &longitude, &locationFix);
            tinygps.crack_datetime(&year, &month, &day, &hour, &minute, &second, &hundredths, &dateFix);
            altitude = tinygps.altitude(); // Altitude in cm (long) - checks that we have received a GGA message
            speed = tinygps.f_speed_mps(); // Get speed - checks that we have received an RMC message
            satellites = tinygps.satellites(); // Get number of satellites
            course = tinygps.course(); // Get course over ground
            hdop = tinygps.hdop(); // Get horizontal dilution of precision
            Serial.print("[DEBUG : read_GPS] ssGPS.available: "); Serial.print( altitude ); Serial.print(" "); Serial.print(speed); Serial.print(" "); Serial.print(satellites); Serial.print(" "); Serial.print(course); Serial.print(" "); Serial.println(hdop);
            fixFound = locationFix != TinyGPS::GPS_INVALID_FIX_TIME && 
                       dateFix != TinyGPS::GPS_INVALID_FIX_TIME && 
                       altitude != TinyGPS::GPS_INVALID_ALTITUDE &&
                       speed != TinyGPS::GPS_INVALID_F_SPEED &&
                       satellites != TinyGPS::GPS_INVALID_SATELLITES &&
                       course != TinyGPS::GPS_INVALID_ANGLE &&
                       hdop != TinyGPS::GPS_INVALID_HDOP &&
                       year != 2000;
            if (EMULATE && charsSeen) {fixFound = true;}
          }          
        }

        // if we haven't seen any GPS data in 10 seconds, then stop waiting
        if (!charsSeen && millis() - tnow > 10000) {
          break;
        }

        // Check battery voltage now we are drawing current for the GPS
        // If voltage is low, stop looking for GPS and go to sleep
        get_vbat();
        if (vbat < VBAT_LOW) {
          break;
        }

#ifndef NoLED
        // 'Flash' the LED
        if ((millis() / 1000) % 2 == 1) {
          LED_dim_blue();
        }
        else {
          LED_blue();
        }
#endif

      }

      Serial.println(charsSeen ? fixFound ? F("[INFO : read_GPS] A GPS fix was found!") : F("[ERROR : read_GPS] No GPS fix was found.") : F("[ERROR : read_GPS] Wiring error: No GPS data seen."));
      Serial.print("[INFO : read_GPS] Latitude (degrees): "); Serial.println(latitude, 6);
      Serial.print("[INFO : read_GPS] Longitude (degrees): "); Serial.println(longitude, 6);
      Serial.print("[INFO : read_GPS] Altitude (m): "); Serial.println(altitude / 100); // Convert altitude from cm to m

      if (vbat < VBAT_LOW) {
        Serial.print("[ERROR : read_GPS] ***!!! LOW VOLTAGE (read_GPS) ");
        Serial.print(vbat,2);
        Serial.println("V !!!***");
        loop_step = zzz;
      }
      else if (!charsSeen) {
        Serial.println("[ERROR : read_GPS] ***!!! No GPS data received !!!***");
        loop_step = zzz;
      }
      else {
        loop_step = read_pressure;
      }
      
      break;

    case read_pressure:
  
      // Start the MPL3115A2 (does Wire.begin())
      if (baro.begin()) {
        // Read pressure twice to avoid first erroneous value
        pascals = baro.getPressure();
        pascals = baro.getPressure();
        if (pascals > 110000) pascals = 0.0; // Correct wrap-around if pressure drops too low
        tempC = baro.getTemperature();
      }
      else {
        Serial.println("[ERROR : read_pressure] ***!!! Error initialising MPL3115A2 !!!***");
        pascals = 0.0;
        tempC = 0.0;
      }

      Serial.print("[INFO : read_pressure] Pressure (Pascals): "); Serial.println(pascals,0);
      Serial.print("[INFO : read_pressure] Temperature (C): "); Serial.println(tempC,1);

       // Power down the GPS and MPL3115A2
      Serial.println("[INFO : read_pressure] Powering down the GPS and MPL3115A2...");
      digitalWrite(GPS_EN, GPS_OFF); // Disable the GPS and MPL3115A2

      loop_step = read_DaisyChain;

      break;


    case read_DaisyChain:

      // Start reading instrument daisy chain

      Serial.println("[INFO : read_DaisyChain] START reading daisy chain instrument data");

      ssDaisyChain.begin(9600);
      ssDaisyChain.setTimeout(2000);
      pinPeripheral(2, PIO_SERCOM);
      pinPeripheral(5, PIO_SERCOM);
      delay(1100);
      if (ssDaisyChain.available() > 0) {
        //DaisyChain_Xdata = ssDaisyChain.readString();        
        ssDaisyChain.readBytesUntil('\0',DaisyChainBuffer, 63);
        //Serial.print("[INFO : read_DaisyChain] RECEIVED from daisy chain: "); Serial.println(DaisyChain_Xdata);
        Serial.print("[INFO : read_DaisyChain] RECEIVED from daisy chain: "); Serial.println(DaisyChainBuffer);
      } else {
        Serial.println("[ERROR : read_DaisyChain] NO instruments connected");
      }

      loop_step = start_iMET;

      break;


    case start_iMET:

      // Start reading iMET radiosonde

      Serial.println("[INFO : start_iMET] START Reading iMET Radiosonde data");

      ssiMET.begin(9600);
      ssiMET.setTimeout(2000);
      delay(1100);      
      if (ssiMET.available() > 0) {
        //iMET_Xdata = ssiMET.readString();        
        ssiMET.readBytesUntil('\0', iMETBuffer, 14);
        //Serial.print("[INFO : start_iMET] RECEIVED from iMET: "); Serial.println(iMET_Xdata);
        Serial.print("[INFO : start_iMET] RECEIVED from iMET: "); Serial.println(iMETBuffer);
      } else {
        Serial.println("[ERROR : start_iMET] iMET instrument NOT connected");
      }

      // Send daisy chain XData to iMET
      //Serial.print("[INFO : start_iMET] SENDING to iMET: "); Serial.println(DaisyChain_Xdata.c_str());
      //ssiMET.write(DaisyChain_Xdata.c_str());
      Serial.print("[INFO : start_iMET] SENDING to iMET: "); Serial.println(DaisyChainBuffer);
      ssiMET.write(DaisyChainBuffer);
     
     
      loop_step = start_LTC3225;

      break;

   
    case start_LTC3225:

#ifndef NoLED
      LED_cyan(); // Set LED to Cyan
#endif

      // Power up the LTC3225EDDB super capacitor charger
      Serial.println("[INFO : start_LTC3225] Powering up the LTC3225EDDB");
      Serial.println("[INFO : start_LTC3225] Waiting for PGOOD to go HIGH...");
      digitalWrite(LTC3225shutdown, HIGH); // Enable the LTC3225EDDB supercapacitor charger
      delay(1000); // Let PGOOD stabilise
      
      // Allow 10 mins for LTC3225 to achieve PGOOD
      PGOOD = digitalRead(LTC3225PGOOD);
      for (tnow = millis(); !PGOOD && millis() - tnow < 10UL * 60UL * 1000UL;)
      {
#ifndef NoLED
        // 'Flash' the LED
        if ((millis() / 1000) % 2 == 1) {
          LED_dim_cyan();
        }
        else {
          LED_cyan();
               
        }
#endif

        // Check battery voltage now we are drawing current for the LTC3225
        // If voltage is low, stop LTC3225 and go to sleep
        get_vbat();
        if (vbat < VBAT_LOW) {
          break;
        }

        PGOOD = digitalRead(LTC3225PGOOD);
        if (EMULATE) {PGOOD = 1;} 
      }

      // If voltage is low or supercapacitors did not charge then go to sleep
      if (vbat < VBAT_LOW) {
        Serial.print("[ERROR : start_LTC3225] ***!!! LOW VOLTAGE (start_LTC3225) ");
        Serial.print(vbat,2);
        Serial.println("V !!!***");
        loop_step = zzz;
      }
      else if (PGOOD == LOW) {
        Serial.println("[ERROR : start_LTC3225] ***!!! LTC3225 !PGOOD (start_LTC3225) !!!***");
        loop_step = zzz;
      }
      // Otherwise start up the Iridium 9603
      else {
        loop_step = wait_LTC3225;
      }
      
      break;

    case wait_LTC3225:
      // Allow extra time for the super capacitors to charge
      Serial.println("[INFO : wait_LTC3225] PGOOD has gone HIGH");
      Serial.println("[INFO : wait_LTC3225] Allowing extra time to make sure capacitors are charged...");
      
      // Allow 20s for extra charging
      PGOOD = digitalRead(LTC3225PGOOD);
      if (EMULATE) {PGOOD = 1;} 
      for (tnow = millis(); PGOOD && millis() - tnow < 1UL * 20UL * 1000UL;)
      {
#ifndef NoLED
      // 'Flash' the LED
      if ((millis() / 1000) % 2 == 1) {
        LED_dim_cyan();
      }
      else {
        LED_cyan();
      }
#endif

        // Check battery voltage now we are drawing current for the LTC3225
        // If voltage is low, stop LTC3225 and go to sleep
        get_vbat();
        if (vbat < VBAT_LOW) {
          break;
        }

        PGOOD = digitalRead(LTC3225PGOOD);
        if (EMULATE) {PGOOD = 1;}
      }

      // If voltage is low or supercapacitors did not charge then go to sleep
      if (vbat < VBAT_LOW) {
        Serial.print("[ERROR : wait_LTC3225] ***!!! LOW VOLTAGE (wait_LTC3225) ");
        Serial.print(vbat,2);
        Serial.println("V !!!***");
        loop_step = zzz;
      }
      else if (PGOOD == LOW) {
        Serial.println("[ERROR : wait_LTC3225] ***!!! LTC3225 !PGOOD (wait_LTC3225) !!!***");
        loop_step = zzz;
      }
      // Otherwise start up the Iridium 9603
      else {
        loop_step = start_9603;
      }
      
      break;

    case start_9603:

#ifndef NoLED
      LED_white(); // Set LED to White
#endif

      // Start talking to the 9603 and power it up
      Serial.println("[INFO : start_9603] Beginning to talk to the 9603...");

      digitalWrite(Enable_9603N, HIGH); // Enable the 9603N
      delay(2000);

      ssIridium.begin(19200);
      delay(1000);
      
      if (isbd.begin() == ISBD_SUCCESS) // isbd.begin powers up the 9603
       {
        char outBuffer[120]; // Always try to keep message short (maximum should be ~101 chars including RockBLOCK destination and source)
    
        if (fixFound)
        {
          if (RBDESTINATION > 0) {
            sprintf(outBuffer, "RB%07d,%d%02d%02d%02d%02d%02d,", RBDESTINATION, year, month, day, hour, minute, second);
          }
          else {
            sprintf(outBuffer, "%d%02d%02d%02d%02d%02d,", year, month, day, hour, minute, second);
          }
          int len = strlen(outBuffer);
          PString str(outBuffer + len, sizeof(outBuffer) - len);
          str.print(latitude, 6);
          str.print(",");
          str.print(longitude, 6);
          str.print(",");
          str.print(altitude / 100); // Convert altitude from cm to m
          str.print(",");
          str.print(speed, 1); // Speed in metres per second
          str.print(",");
          str.print(course / 100); // Convert from 1/100 degree to degrees
          str.print(",");
          str.print((((float)hdop) / 100),1); // Convert from 1/100 m to m
          str.print(",");
          str.print(satellites);
          str.print(",");
          str.print(pascals, 0);
          str.print(",");
          str.print(tempC, 1);
          str.print(",");
          str.print(vbat, 2);
          str.print(",");
          str.print(iMET_Xdata.substring(6));
          str.print(",");
          str.print(DaisyChain_Xdata.substring(6));
          str.print(",");
          str.print(float(iterationCounter), 0);
          if (RBDESTINATION > 0) { // Append source RockBLOCK serial number (as text) to the end of the message
            char sourceBuffer[12];
            sprintf(sourceBuffer, "RB%07d", RBSOURCE);
            str.print(",");
            str.print(sourceBuffer);
          }
        }
    
        else
        {
          // No GPS fix found!
          if (RBDESTINATION > 0) {
            sprintf(outBuffer, "RB%07d,19700101000000,0.0,0.0,0,0.0,0,0.0,0,", RBDESTINATION);
          }
          else {
            sprintf(outBuffer, "19700101000000,0.0,0.0,0,0.0,0,0.0,0,");
          }
          int len = strlen(outBuffer);
          PString str(outBuffer + len, sizeof(outBuffer) - len);
          str.print(pascals, 0);
          str.print(",");
          str.print(tempC, 1);
          str.print(",");
          str.print(vbat, 2);
          str.print(",");
          str.print(iMET_Xdata.substring(6));
          str.print(",");
          str.print(DaisyChain_Xdata.substring(6));
          str.print(",");
          str.print(float(iterationCounter), 0);
          if (RBDESTINATION > 0) { // Append source RockBLOCK serial number (as text) to the end of the message
            char sourceBuffer[12];
            sprintf(sourceBuffer, "RB%07d", RBSOURCE);
            str.print(",");
            str.print(sourceBuffer);
          }
        }

        Serial.print("[INFO : start_9603N] Transmitting message (size = "); Serial.print(strlen(outBuffer)); Serial.print(" bytes) '");
        Serial.print(outBuffer);
        Serial.println("'");
        uint8_t mt_buffer[100]; // Buffer to store Mobile Terminated SBD message
        size_t mtBufferSize = sizeof(mt_buffer); // Size of MT buffer

        if (isbd.sendReceiveSBDText(outBuffer, mt_buffer, mtBufferSize) == ISBD_SUCCESS) { // Send the message; download an MT message if there is one
          if (mtBufferSize > 0) { // Was an MT message received?
            // Check message content
            mt_buffer[mtBufferSize] = 0; // Make sure message is NULL terminated
            String mt_str = String((char *)mt_buffer); // Convert message into a String
            Serial.print("Received a MT message: "); Serial.println(mt_str);

            // Check if the message contains a correctly formatted BEACON_INTERVAL: "[INTERVAL=nnn]"
            int new_interval = 0;
            int starts_at = -1;
            int ends_at = -1;
            starts_at = mt_str.indexOf("[INTERVAL="); // See is message contains "[INTERVAL="
            if (starts_at >= 0) { // If it does:
              ends_at = mt_str.indexOf("]", starts_at); // Find the following "]"
              if (ends_at > starts_at) { // If the message contains both "[INTERVAL=" and "]"
                String new_interval_str = mt_str.substring((starts_at + 10),ends_at); // Extract the value after the "="
                Serial.print("Extracted an INTERVAL of: "); Serial.println(new_interval_str);
                new_interval = (int)new_interval_str.toInt(); // Convert it to int
              }
            }
            if ((new_interval > 0) and (new_interval <= 1440)) { // Check new interval is valid
              Serial.print("New BEACON_INTERVAL received. Setting BEACON_INTERVAL to ");
              Serial.print(new_interval);
              Serial.println(" minutes.");
              BEACON_INTERVAL = new_interval; // Update BEACON_INTERVAL
              // Update flash memory
              flashVars.PREFIX = 0xB5; // Reset the prefix (hopefully redundant!)
              flashVars.INTERVAL = new_interval; // Store the new beacon interval
              int csum = flashVars.PREFIX + flashVars.INTERVAL + flashVars.RBSOURCE + flashVars.RBDESTINATION; // Update the checksum
              csum = csum & 0xff;
              flashVars.CSUM = csum;
              flashVarsMem.write(flashVars); // Write the flash variables
            }

            // Check if the message contains a correctly formatted RBSOURCE: "[RBSOURCE=nnnnn]"
            int new_source = -1;
            starts_at = -1;
            ends_at = -1;
            starts_at = mt_str.indexOf("[RBSOURCE="); // See is message contains "[RBSOURCE="
            if (starts_at >= 0) { // If it does:
              ends_at = mt_str.indexOf("]", starts_at); // Find the following "]"
              if (ends_at > starts_at) { // If the message contains both "[RBSOURCE=" and "]"
                String new_source_str = mt_str.substring((starts_at + 10),ends_at); // Extract the value after the "="
                Serial.print("Extracted an RBSOURCE of: "); Serial.println(new_source_str);
                new_source = (int)new_source_str.toInt(); // Convert it to int
              }
            }
            // toInt returns zero if the conversion fails, so it is not possible to distinguish between a source of zero and an invalid value!
            // An invalid value will cause RBSOURCE to be set to zero
            if (new_source >= 0) { // If new_source was received
              Serial.print("New RBSOURCE received. Setting RBSOURCE to ");
              Serial.println(new_source);
              RBSOURCE = new_source; // Update RBSOURCE
              // Update flash memory
              flashVars.PREFIX = 0xB5; // Reset the prefix (hopefully redundant!)
              flashVars.RBSOURCE = new_source; // Store the new RockBLOCK source serial number
              int csum = flashVars.PREFIX + flashVars.INTERVAL + flashVars.RBSOURCE + flashVars.RBDESTINATION; // Update the checksum
              csum = csum & 0xff;
              flashVars.CSUM = csum;
              flashVarsMem.write(flashVars); // Write the flash variables
            }

            // Check if the message contains a correctly formatted RBDESTINATION: "[RBDESTINATION=nnnnn]"
            int new_destination = -1;
            starts_at = -1;
            ends_at = -1;
            starts_at = mt_str.indexOf("[RBDESTINATION="); // See is message contains "[RBDESTINATION="
            if (starts_at >= 0) { // If it does:
              ends_at = mt_str.indexOf("]", starts_at); // Find the following "]"
              if (ends_at > starts_at) { // If the message contains both "[RBDESTINATION=" and "]"
                String new_destination_str = mt_str.substring((starts_at + 15),ends_at); // Extract the value after the "="
                Serial.print("Extracted an RBDESTINATION of: "); Serial.println(new_destination_str);
                new_destination = (int)new_destination_str.toInt(); // Convert it to int
              }
            }
            // toInt returns zero if the conversion fails, so it is not possible to distinguish between a destination of zero and an invalid value!
            // An invalid value will cause RBDESTINATION to be set to zero
            if (new_destination >= 0) { // If new_destination was received
              Serial.print("New RBDESTINATION received. Setting RBDESTINATION to ");
              Serial.println(new_destination);
              RBDESTINATION = new_destination; // Update RBDESTINATION
              // Update flash memory
              flashVars.PREFIX = 0xB5; // Reset the prefix (hopefully redundant!)
              flashVars.RBDESTINATION = new_destination; // Store the new RockBLOCK destination serial number
              int csum = flashVars.PREFIX + flashVars.INTERVAL + flashVars.RBSOURCE + flashVars.RBDESTINATION; // Update the checksum
              csum = csum & 0xff;
              flashVars.CSUM = csum;
              flashVarsMem.write(flashVars); // Write the flash variables
            }



/*         Delete this 
            // Check if the message contains a correctly formatted RADIO message: "[RADIO=nnnnnnnn]"
            String new_radio_str;
            int new_radio = -1;
            starts_at = -1;
            ends_at = -1;
            starts_at = mt_str.indexOf("[RADIO="); // See is message contains "[RADIO="
            if (starts_at >= 0) { // If it does:
              ends_at = mt_str.indexOf("]", starts_at); // Find the following "]"
              if (ends_at > starts_at) { // If the message contains both "[RADIO=" and "]"
                new_radio_str = mt_str.substring((starts_at + 7),ends_at); // Extract the value after the "="
                Serial.print("Extracted a RADIO message of: "); Serial.println(new_radio_str);
                new_radio = 1;
              }
            }
  
            if (new_radio == 1) { // If a new radio message was received
              Serial.print("New RADIO message received. Sending: ");
              Serial.println(new_radio_str);
              // Wake up the eRIC
              digitalWrite(eRIC_WAKE, HIGH); // Enable eRIC
              // (Re)Start the eRIC serial port
              sseRIC.begin(19200);
              delay(2000); // Allow time for the port to open and for eRIC to start
              // (Re)Configure the eRIC - this should be unnecessary - but just in case!
              // Serial data from the eRIC is ignored - so the code won't hang
              // if the radio board is not connected
              sseRIC.print("ER_CMD#R1"); // Reset Radio
              delay(50);
              sseRIC.print("ACK"); // Acknowledge
              delay(500);
              while(sseRIC.available()){sseRIC.read();} // Clear the serial rx buffer
              sseRIC.print("ER_CMD#C5"); // Set Channel 5
              delay(50);
              sseRIC.print("ACK"); // Acknowledge
              delay(50);
              while(sseRIC.available()){sseRIC.read();} // Clear the serial rx buffer
              sseRIC.print("ER_CMD#B0"); // Set Over-Air Baud Rate to 1200
              delay(50);
              sseRIC.print("ACK"); // Acknowledge
              delay(50);
              while(sseRIC.available()){sseRIC.read();} // Clear the serial rx buffer
              sseRIC.print("ER_CMD#P0"); // Set Transmit Power to 0dBm
              delay(50);
              sseRIC.print("ACK"); // Acknowledge
              delay(50);
              while(sseRIC.available()){sseRIC.read();} // Clear the serial rx buffer
              sseRIC.print("ER_CMD#D2"); // Set RX Power Saving
              delay(50);
              sseRIC.print("ACK"); // Acknowledge
              delay(500);
              while(sseRIC.available()){sseRIC.read();} // Clear the serial rx buffer
              sseRIC.print("ER_CMD#d2"); // Set TX Power Saving
              delay(50);
              sseRIC.print("ACK"); // Acknowledge
              delay(500);
              while(sseRIC.available()){sseRIC.read();} // Clear the serial rx buffer
              // Now send the radio message three times for redundancy
              sseRIC.print(new_radio_str);
              delay(1500);
              sseRIC.print(new_radio_str);
              delay(1500);
              sseRIC.print(new_radio_str);
              delay(1500);
              // Put eRIC back into Low Power Mode 0
              sseRIC.print("ER_CMD#A21"); // Set Low Power Mode 0
              delay(50);
              sseRIC.print("ACK"); // Acknowledge
              delay(500);
              while(sseRIC.available()){sseRIC.read();} // Clear the serial rx buffer
              digitalWrite(eRIC_WAKE, LOW); // Disable eRIC
            }
            */

            // Check if the message contains a correctly formatted relay pulse command: "[RELAY=1]" to "[RELAY=5]"
            starts_at = -1;
            starts_at = mt_str.indexOf("[RELAY=1]"); // See if message contains "[RELAY=1]"
            if (starts_at >= 0) { // If it does, set the flag to allow relay to be pulsed once 9603N is powered down:
              set_relay_flag = false;
              reset_relay_flag = false;
              pulse_relay_flag = true;
              relay_pulse_duration = 1;
              Serial.println("[RELAY=1] received.");
            }
            starts_at = -1;
            starts_at = mt_str.indexOf("[RELAY=2]"); // See is message contains "[RELAY=2]"
            if (starts_at >= 0) { // If it does, set the flag to allow relay to be pulsed once 9603N is powered down:
              set_relay_flag = false;
              reset_relay_flag = false;
              pulse_relay_flag = true;
              relay_pulse_duration = 2;
              Serial.println("[RELAY=2] received.");
            }
            starts_at = -1;
            starts_at = mt_str.indexOf("[RELAY=3]"); // See is message contains "[RELAY=3]"
            if (starts_at >= 0) { // If it does, set the flag to allow relay to be pulsed once 9603N is powered down:
              set_relay_flag = false;
              reset_relay_flag = false;
              pulse_relay_flag = true;
              relay_pulse_duration = 3;
              Serial.println("[RELAY=3] received.");
            }
            starts_at = -1;
            starts_at = mt_str.indexOf("[RELAY=4]"); // See is message contains "[RELAY=4]"
            if (starts_at >= 0) { // If it does, set the flag to allow relay to be pulsed once 9603N is powered down:
              set_relay_flag = false;
              reset_relay_flag = false;
              pulse_relay_flag = true;
              relay_pulse_duration = 4;
              Serial.println("[RELAY=4] received.");
            }
            starts_at = -1;
            starts_at = mt_str.indexOf("[RELAY=5]"); // See is message contains "[RELAY=5]"
            if (starts_at >= 0) { // If it does, set the flag to allow relay to be pulsed once 9603N is powered down:
              set_relay_flag = false;
              reset_relay_flag = false;
              pulse_relay_flag = true;
              relay_pulse_duration = 5;
              Serial.println("[RELAY=5] received.");
            }

            // Check if the message contains a correctly formatted relay command: "[RELAY=ON]" or "[RELAY=OFF]"
            starts_at = -1;
            starts_at = mt_str.indexOf("[RELAY=ON]"); // See is message contains "[RELAY=ON]"
            if (starts_at >= 0) { // If it does, set the flag to allow relay to be changed once 9603N is powered down:
              set_relay_flag = true;
              reset_relay_flag = false;
              pulse_relay_flag = false; // set overrides pulse
              Serial.println("[RELAY=ON] received.");
            }
            starts_at = -1;
            starts_at = mt_str.indexOf("[RELAY=OFF]"); // See is message contains "[RELAY=OFF]"
            if (starts_at >= 0) { // If it does, set the flag to allow relay to be changed once 9603N is powered down:
              reset_relay_flag = true;
              set_relay_flag = false; // reset overrides set
              pulse_relay_flag = false; // reset overrides pulse
              Serial.println("[RELAY=OFF] received.");
            }

          }
#ifndef NoLED
          LED_green(); // Set LED to Green for 2 seconds
          delay(2000);
#endif
        }
        ++iterationCounter; // Increment iterationCounter (regardless of whether send was successful)
      }
      
      loop_step = zzz;

      break;

    case zzz:
    
#ifndef NoLED
      LED_red(); // Set LED to Red
#endif

      // Get ready for sleep
      Serial.println("[INFO : zzz] Putting 9603N and GNSS to sleep...");
      isbd.sleep(); // Put 9603 to sleep
      delay(1000);
      ssIridium.end(); // Close GPS, Iridium, iMET and DaisyChain  serial ports
      ssGPS.end();
      ssiMET.end();
      ssDaisyChain.end();
      delay(1000); // Wait for serial ports to clear
  
      // Disable: GPS; pressure sensor; 9603N; and Iridium supercapacitor charger
      Wire.end(); // Stop I2C comms
      digitalWrite(GPS_EN, GPS_OFF); // Disable the GPS (and MPL3115A2)
      digitalWrite(Enable_9603N, LOW); // Disable the 9603N
      digitalWrite(LTC3225shutdown, LOW); // Disable the LTC3225 supercapacitor charger

      // Now that power draw has been minimised, reset/set/pulse the relay
      if (reset_relay_flag == true) {
        Serial.println("[INFO : zzz] Resetting relay...");
        reset_relay();
        reset_relay_flag = false;
      }
      if (set_relay_flag == true) {
        Serial.println("[INFO : zzz] Setting relay...");
        set_relay();
        set_relay_flag = false;
      }
      if (pulse_relay_flag == true) {
        Serial.println("[INFO : zzz] Pulsing relay...");
        set_relay();
        delay(relay_pulse_duration * 1000);
        reset_relay();
        pulse_relay_flag = false;
      }

      // Turn LED off
      LED_off();
  
      // Close and detach the serial console (as per CaveMoa's SimpleSleepUSB)
      Serial.println("[INFO : zzz] Going to sleep until next alarm time...");
      delay(1000); // Wait for serial port to clear
//      Serial.end(); // Close the serial console
//      USBDevice.detach(); // Safely detach the USB prior to sleeping
    
      // Sleep until next alarm match
      //rtc.standbyMode();  // USE THIS for Operational code
      delay(BEACON_INTERVAL*1000);   // delay only for testing REMOVE
  
      // Wake up!
      loop_step = wake;
  
      break;

    case wake:
      // Attach and reopen the serial console
//      USBDevice.attach(); // Re-attach the USB
      delay(1000);  // Delay added to make serial more reliable

      // Now loop back to init
      loop_step = init;

      break;
  }
}
