PaulLSK/Iridium_9603_Beacon/Arduino/Iridium9603NBeacon_V5M_Test/Feather_Instruments_Broadcaster/Feather_Instruments_Broadcaster.ino

// Serial2 pin and pad definitions (in Arduino files Variant.h & Variant.cpp)
#define PIN_SERIAL2_RX       (34ul)               // Pin description number for PIO_SERCOM on D12 (Physical Pin 28)
#define PIN_SERIAL2_TX       (36ul)               // Pin description number for PIO_SERCOM on D10 (Physical Pin 27)
#define PAD_SERIAL2_TX       (UART_TX_PAD_2)      // SERCOM1 pad 2 (SC1PAD2)
#define PAD_SERIAL2_RX       (SERCOM_RX_PAD_3)    // SERCOM1 pad 3 (SC1PAD3)
// Instantiate the Serial2 class
Uart Serial2(&sercom1, PIN_SERIAL2_RX, PIN_SERIAL2_TX, PAD_SERIAL2_RX, PAD_SERIAL2_TX);
HardwareSerial &ssSerial2(Serial2);

/*
// SERCOM4 -> Serial3 -> iMET
// Serial3 pin and pad definitions (in Arduino files Variant.h & Variant.cpp)
// iMET Tx (input) is connected to MOSI (Digital Pin 23, Port B Pin 10, SERCOM4 Pad 2, Serial3 Tx)
// iMET Rx (output) is connected to SCK (Digital Pin 24, Port B Pin 11, SERCOM4 Pad 3, Serial3 Rx)
#define PIN_SERIAL3_RX       (24ul)               // Pin description number for PIO_SERCOM on D24
#define PIN_SERIAL3_TX       (23ul)               // Pin description number for PIO_SERCOM on D23
#define PAD_SERIAL3_TX       (UART_TX_PAD_2)      // SERCOM4 Pad 2 (SC4PAD2)
#define PAD_SERIAL3_RX       (SERCOM_RX_PAD_3)    // SERCOM4 Pad 3 (SC4PAD3)
// Instantiate the Serial3 class
Uart Serial3(&sercom4, PIN_SERIAL3_RX, PIN_SERIAL3_TX, PAD_SERIAL3_RX, PAD_SERIAL3_TX);
HardwareSerial &ssInst2(Serial3);
*/

// Interrupt handler for SERCOM1 (essential for Serial2 comms)
void SERCOM1_Handler()
{
  Serial2.IrqHandler();
}
/*
// Interrupt handler for SERCOM4 (essential for Serial3 comms)
void SERCOM4_Handler()
{
  Serial3.IrqHandler();
}
*/


/* CNC variables in XDATA string */
int16_t CNC_300 = 111;    //OPC 300nm channel counts aka CN counts
int16_t CNC_500 = 222;    //OPC 500nm channel counts
int16_t CNC_700 = 333;    //OPC 700nm channel counts
int8_t Pump1_PWM = 77;  //Pump1 PWM drive percent (0-100)
int8_t Pump2_PWM = 88;  //Pump2 PWM drive percent (0-100)
int16_t TempCN = 4444;   //Temperature of the staurator C 0.01 resolution
int8_t TempIce = 55;  //Temperature of Ice Jacket C 1 resolution
int8_t TempPCB = 66;  //Temperature of the control boars C 1 resolution


void setup() {
  Serial.begin(115200);
  Serial1.begin(9600);
  ssSerial2.begin(9600); 
}

int count = 0;

void loop() {
  // put your main code here, to run repeatedly:

#define MAX_MILLIS_TO_WAIT 1000  //or whatever

  char outBuffer[120];
  char outBuffer1[120];
  unsigned long starttime;
  String BEACON_Xdata = "";
  //char iMET_Xdata[120] = "";
  //int char_loc = 0;
  //bool datafound = false;
  
  starttime = millis();

/*
  while (Serial1.available() > 0) {
    iMET_Xdata[char_loc] = Serial1.read();
    char_loc++;
    datafound = true;
  }

  if (datafound) {
    Serial.print("[INFO : start_iMET] RECEIVED from iMET: "); Serial.println(iMET_Xdata);
    memset(iMET_Xdata, 0, sizeof(iMET_Xdata));
    datafound = false;
  } else {
    Serial.println("[ERROR : start_iMET] iMET instrument NOT connected");
  }
*/
/*
  if (Serial1.available() > 0) {
    BEACON_Xdata = Serial1.readStringUntil('\n');
    Serial.print("[INFO : start_BEACON_Read] RECEIVED from BEACON: "); Serial.println(BEACON_Xdata);
  } else {
    Serial.println("[ERROR : start_BEACON_Read] BEACON instrument NOT connected");
  }  

*/

  //sprintf(outBuffer, "xdata=4102%4hX%4hX%4hX%2hX%2hX%4hX%2hX%2hX\r", CNC_300, CNC_500, CNC_700, Pump1_PWM, Pump2_PWM, TempCN, TempIce, TempPCB);
  sprintf(outBuffer, "xdata=4102AF1C00A600262A0E9F0BBD7880\r");
  Serial.print("SENDING to BEACON on SERIAL1: "); Serial.println(outBuffer);
  Serial1.write(outBuffer);

/*
  
  sprintf(outBuffer1, "xdata=0202%013d\r\n", count);
  Serial.print("SENDING to BEACON on SERIAL2: "); Serial.println(outBuffer1);
  ssSerial2.write(outBuffer1);
*/

  count++;

  delay(1000);

}
