PaulLSK/Iridium_9603_Beacon/(commit log)

2018-12-20 Adding extra batteries to board schematic and layout)
    [Iridium_9603_Beacon.brd, Iridium_9603_Beacon.sch, Iridium_9603_Beacon_V5M.brd, Iridium_9603_Beacon_V5M.sch]
2019-01-02 preliminary changes to V5M board
    [142-0711-821.stp, 93090A635_PRESS-FIT FEMALE ROUND STANDOFFS.STEP, AA_Battery.b877e503-0576-4231-a7e3-62d7da980c33.f3d, BSO-M3-20ZI-PennEngineering-12-31-2018.stp, Iridium_9603_Beacon_V5M(1).step, Iridium_9603_Beacon_V5M.brd, Iridium_9603_Beacon_V5M.sch, c-0102618-51-k-3d.stp]
2019-01-03 removing backup eagle files, edits to V5M PCB board
    [Iridium_9603_Beacon_V5M.brd, Iridium_9603_Beacon_V5M.sch]
2019-01-03 Clean version of board modifications. Extra batteries, switch added. Reset button flipped to bottom. Moved USB port. NO EXTRA serial port yet.
    [Iridium_9603_Beacon_V5M.brd, Iridium_9603_Beacon_V5M.sch]
2019-01-04 several changes to the board layout. Switched digital I/O lines for coil reset and charger shutdown. Added extra serial port.
    [Iridium_9603_Beacon_V5M.brd, Iridium_9603_Beacon_V5M.sch, Iridium_9603_Beacon_V5_BOM_Digikey.xls]
2019-01-08 updated CAD file, BOM, Gerber files generated for initial version of the board
    [BOM TEMPLATE for AAPCB.xlsx, Iridium Board V5M - BOM for AAPCB - Revision 2.xlsx, Iridium_9603_Beacon_V5M(1).step, Iridium_9603_Beacon_V5M(4).step, Iridium_9603_Beacon_V5M.brd, Iridium_9603_Beacon_V5M.sch, Iridium_9603_Beacon_V5M_Eagle_BOM.csv, Iridium_9603_Beacon_V5M_Eagle_BOM.xlsx]
2019-01-15 Testing both serial ports in Arduino
    [142-0701-871.stp, Iridium_9603_Beacon_V5M.brd]
2019-01-15 Board layout updated to pass OSH Park rules (mostly)
    [Iridium_9603_Beacon_V5M.brd]
2019-01-17 Latest clean version of the board. Updated USB connector for 3 mil width polygons
    [Iridium_9603_Beacon_V5M.brd, Iridium_9603_Beacon_V5M.sch]
2019-01-23 starting operational Iridium9603NBeacon_V5M arduiono code
    [G6SK_2.step, Iridium Board V5M - BOM for AAPCB - Revision 2.xlsx, Iridium_9603_Beacon_V5M(4).step, Iridium_9603_Beacon_V5M(5) - OSH Park R0 Order.step, Iridium_9603_Beacon_V5M(7).step, Iridium_9603_Beacon_V5M.brd, LCS 032 RTP.IGS, LF10WBR-C.stp]
2019-02-04 Added diode to second battery pack
    [Iridium Board V5M - BOM for AAPCB - Revision 2.xlsx, Iridium_9603_Beacon_V5M.brd, Iridium_9603_Beacon_V5M.sch]
2019-02-15 Board as submitted to AAPCB
    [Iridium Board V5M - BOM for AAPCB - Revision 2.xlsx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]
2019-02-21 updated BOM. started new operational code. Iridium9603NBeacon_V5M_XDATA
    [Iridium Board V5M - BOM for AAPCB - Revision 2.xlsx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]
2019-03-13 repository at time of board shipment
    [Beacon Board Test Report.xlsx]
